Swimnato/Simulation-Main-Board/README.md

# Simulation Main Board
A universal board for creating simulation panels for the Christa McCaullife Space Center. Created and maintained by NF 2025.

For getting started with the library please visit the [Library Guide](Library%20Guide.md)
