Swimnato/Simulation-Main-Board/Release Packages/REV A0 - First Release/Example Good.png

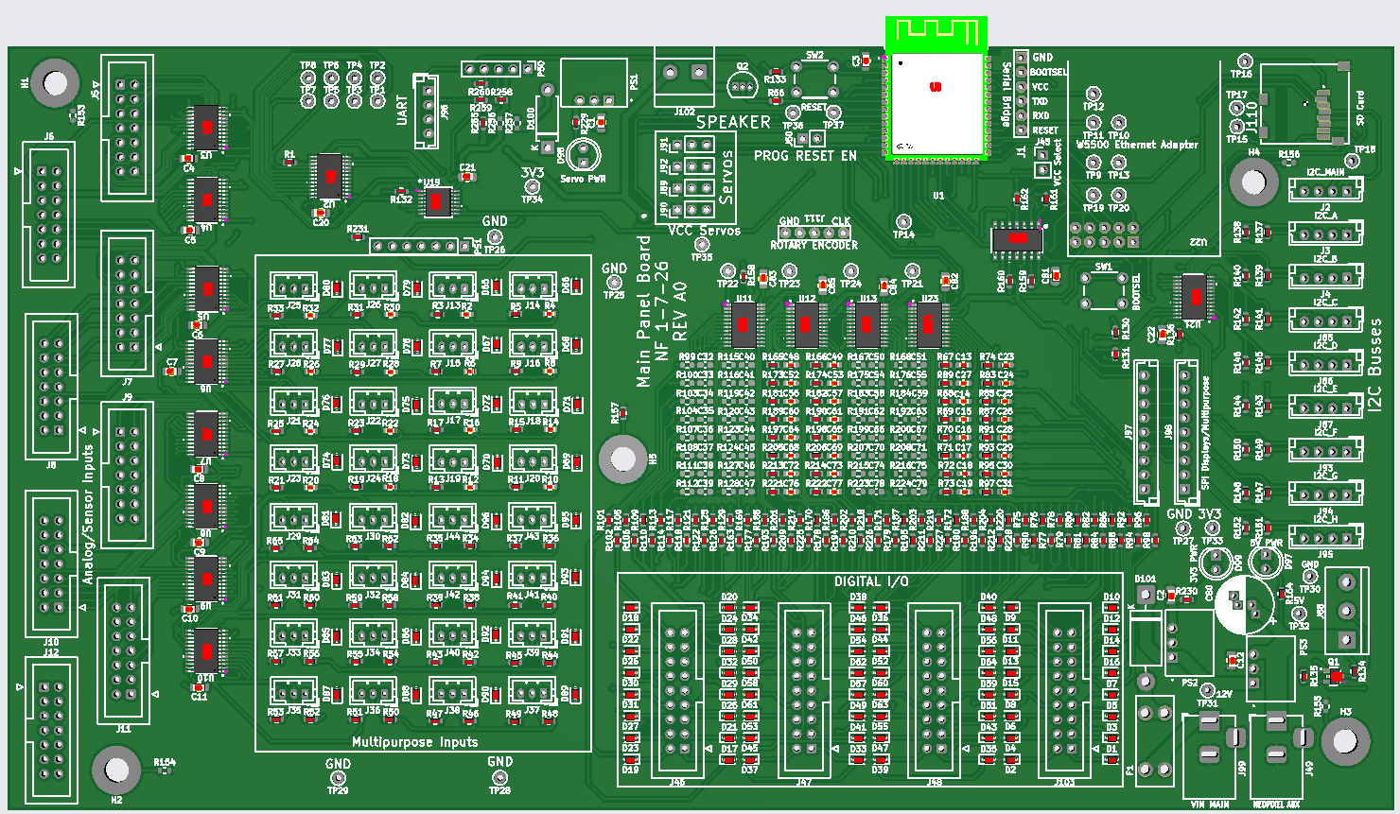
Release Packages/REV A0 - First Release/Example Good.png
