Swimnato/Simulation-Main-Board/Release Packages/REV A0 - First Release/Ali_Express Parts.xlsx

Designator | Description | link | QTY
Q2 | 2N2222 | https://www.aliexpress.us/item/3256808643065539.html | 1
C80 | 1000uF 50V | https://www.aliexpress.us/item/3256802338659126.html | 1
J46,J47,J48,J103 | 18 pin IDC Connector | https://www.aliexpress.us/item/3256808347400918.html | 4
J102 | 2 Pin Screw Block Terminal 5.08mm | https://www.aliexpress.us/item/2251832621219818.html | 1
D97,D98,D99 | 5mm LED (Color Doesn't matter) | https://www.aliexpress.us/item/3256805522196114.html | 3
D100 | Flyback Diode for servos | https://www.aliexpress.us/item/3256805353201767.html | 1
J99,(J49) | DC Barrel Jack | https://www.aliexpress.us/item/2255801020080942.html | 1
N/A | (mini) Blade Car Fuse 4A | https://www.aliexpress.us/item/3256809139622077.html | 1
U22 | W5500 (Blue) | https://www.aliexpress.us/item/3256808177680660.html | 1
