Swimnato/Simulation-Main-Board/Release Packages/REV A0 - First Release/Digikey Parts.xlsx

Designator(s) | Digikey Number | QTY
F1 | 36-3568-ND | 1
D97,D98,D99 | 5962-XL-502SYGD-ND | 3
PS1,PS3 | 945-R-78K5.0-2.0-ND | 2
PS2 | 945-R-78K3.3-2.0-ND | 1
J99 | 486-3381-ND | 1
D100 | 4878-1N4007CT-ND | 1
D101 | 497-6588-2-ND | 1
SW1,SW2 | 2223-TS02-66-60-BK-160-LCR-D-ND | 2
J97,J98 | 455-B9B-XH-A-ND | 2
J13-25, J29-44 | 455-2248-ND, or 455-B2B-XH-A-ND | 32
J5,J6,J7,J8,J9,J10,J11,J12 | S9170-ND | 8
J2,J3,J4,J85,J86,J87,J93,J94,J96 | 455-B4B-XH-A-ND | 10
