Swimnato/Simulation-Main-Board/Release Packages/REV A0 - First Release/BOM JLCPCB Assembly A0.xlsx

Comment | Designator | Footprint | JLCPCB Part #（optional）
ESP32-S3-WROOM-1-N4 | U1 |  | C2913197
BSS138 | Q1 | SOT95-3 | C52895
CD4067BPWR | U4,U3,U5,U2,U10,U6,U8,U9,U7 | 24-TSSOP | C2861251
SN74HCS164PWR | U19 | 14-TSSOP | C406867
74HC125D,653 | U30 | SO14 | C5598
TCA9548APWR | U21 | 24-TSSOP | C130026
TCA9535PWR | U11, U12, U13, U23 | 24-TSSOP | C130204
300R | R164, R229 | 603 | C23025
150R | R230,R169,R170,R201,R171,R193,R185,R82,R177,R81,R219,R129,R178,R114,R113,R211,R94,R172,R217,R188,R105,R226,R92,R86,R110,R187,R195,R88,R79,R109,R180,R84,R220,R121,R98,R186,R194,R126,R101,R227,R196,R117,R76,R202,R218,R96,R106,R203,R90,R78,R102,R228,R122,R212,R179,R125,R163,R209,R80,R204,R75,R118,R210,R225,R77 | 603 | C22808
MEM2061-01-188-00-A | J110 |  | C5151738
DESD5V0S1BA-7 | D87,D53,D37,D89,D81,D45,D60,D29,D88,D93,D75,D24,D47,D92,D73,D56,D70,D86,D84,D31,D6,D64,D83,D20,D19,D62,D67,D76,D8,D46,D5,D18,D66,D40,D82,D72,D25,D30,D36,D9,D65,D80,D90,D55,D50,D17,D26,D57,D38,D34,D15,D14,D59,D21,D10,D39,D58,D85,D13,D63,D35,D68,D16,D51,D61,D41,D42,D49,D1,D91,D69,D52,D77,D27,D78,D33,D74,D79,D7,D54,D22,D44,D94,D43,D96,D95,D28,D48,D12,D23,D32,D11,D2,D4,D3,D71 | SOD-323 | C2157964
10k | R1,R66,R130,R131,R132,R133,R134,R135,R136,R137,R138,R139,R140,R141,R142,R143,R144,R145,R146,R147,R148,R149,R150,R151,R152,R158,R258 | 603 | C98220
100k | R197,R173,R221,R181,R165,R205,R189,R213,R74,R160,R161,R69,R182,R89,R68,R198,R70,R87,R91,R206,R159,R214,R93,R95,R83,R166,R85,R190,R72,R162,R222,R174,R97,R67,R73,R71,R34,R35,R36,R37,R38,R39,R40,R41,R42,R43,R44,R45,R46,R47,R48,R49,R50,R51,R52,R53,R54,R55,R56,R57,R58,R59,R60,R61,R62,R63,R64,R65,R3,R5,R7,R9,R11,R13,R15,R17,R19,R21,R23,R25,R27,R29,R31,R33,R231,R259,R260 | 603 | C25803
0.1uF | C13,C14,C15,C16,C17,C18,C19,C23,C24,C25,C26,C27,C28,C29,C30,C31,C48,C49,C52,C53,C56,C57,C60,C61,C64,C65,C68,C69,C72,C73,C76,C77,R2,R4,R6,R8,R10,R12,R14,R16,R18,R20,R22,R24,R26,R28,R30,R32 | 603 | C14663
10uF | C9,C3,C5,C22,C4,C10,C11,C20,C8,C7,C21,C6,C81,C82,C83,C84,C85 | 805 | C15850
0R | R157,R255 | 603 | C21189
22uF | C2,C12,C1 | 805 | C45783
