Swimnato/Simulation-Main-Board/Release Packages/REV A0 - First Release/Main Board 3D Model A0.3mf

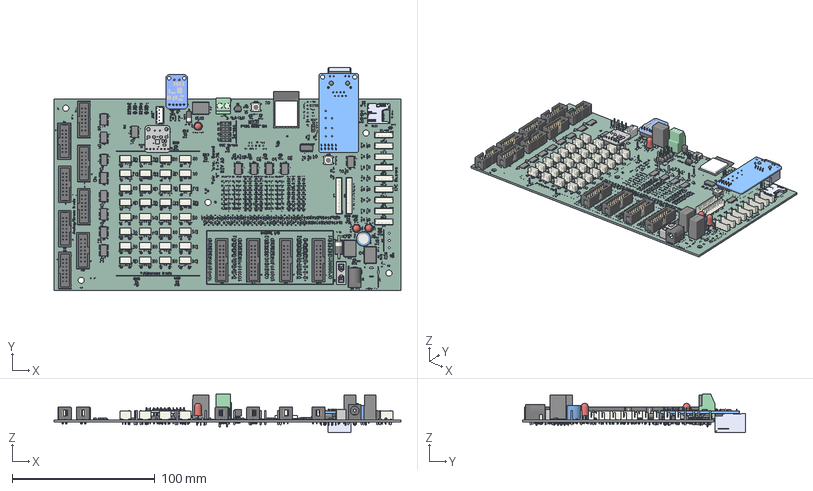
[picture p2: CAD file, 2026-01-08]
Release Packages/REV A0 - First Release/Main Board 3D Model A0.3mf
243.2 x 156.0 x 27.2 mm
