Swimnato/Simulation-Main-Board/3D Models/Components/2130 PAM8302.step

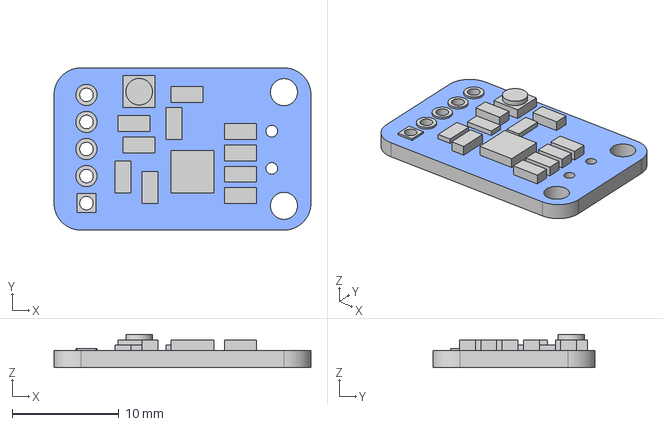
[picture p3: CAD file, 2026-01-07]
3D Models/Components/2130 PAM8302.step
24.1 x 15.2 x 3.10 mm
