Swimnato/Simulation-Main-Board/ESP32 S3/ESP32-S3-WROOM-1-N16.STEP

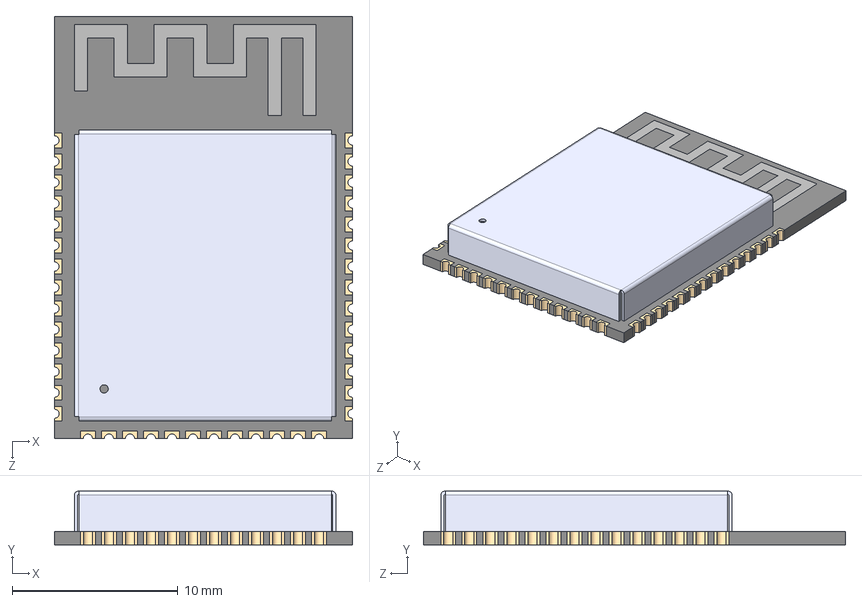
[picture p4: CAD file, 2025-09-20]
ESP32 S3/ESP32-S3-WROOM-1-N16.STEP
18.0 x 3.25 x 25.5 mm
