Swimnato/Simulation-Main-Board/3D Models/Components/3006 MAX98357.step

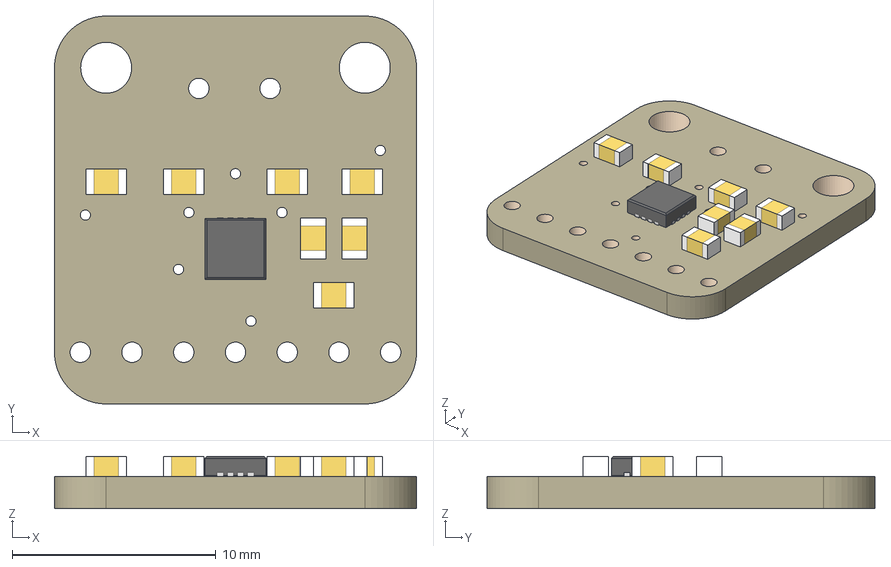
[picture p5: CAD file, 2026-01-07]
3D Models/Components/3006 MAX98357.step
17.8 x 19.1 x 2.57 mm
Board
MAX98357A
220pF x 7
