Swimnato/Simulation-Main-Board/3D Models/Components/JST XH 4 B4B-XH-A.STEP

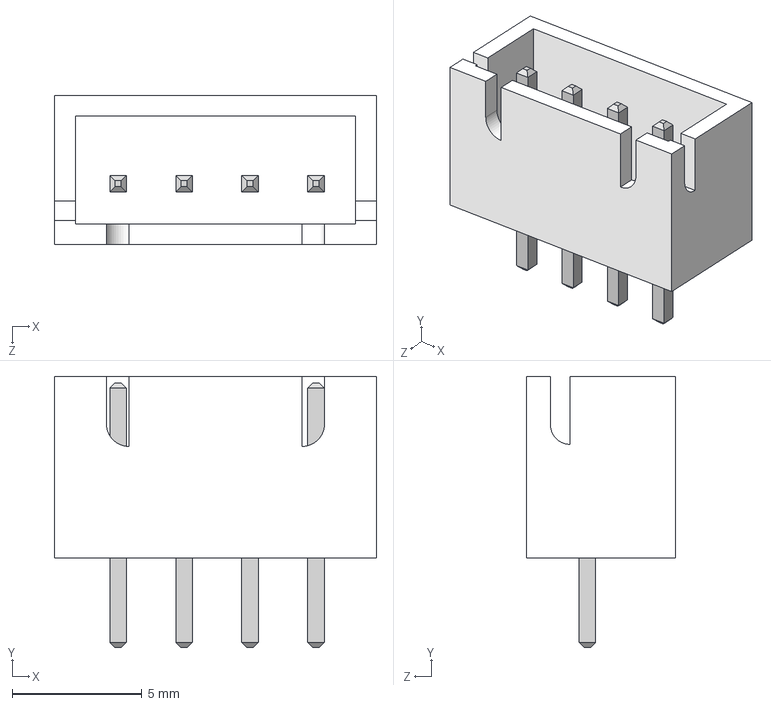
[picture p6: CAD file, 2026-01-07]
3D Models/Components/JST XH 4 B4B-XH-A.STEP
12.4 x 10.5 x 5.75 mm
