Swimnato/Simulation-Main-Board/Release Packages/REV A0 - First Release/JLCBPCB_Instructions.txt

Upload Main Board CAM Data A0.zip to JLCPCB (go to JLCPCB.com >> Instant Quote >> Drag zip into upload folder)

WAIT FOR THE PCB TO FINISH UPLOADING BEFORE EDITING PARAMETERS

Changes needed:
Surface Finish - LeadFree HASL
Enable PCB Assembly
Assemble Top Side
PCBA Type - Standard
Qty - 5
Confirm Parts Placement - Yes (ON POPUP "Do Not Confirm Automatically" to true) 
Board Cleaning - Yes

Hit NEXT

Verify the top side is showing (You should see text "Main Panel Board" in the center)

Hit NEXT

Upload BOM and CPL File
- BOM is "BOM JLCPCB Assembly A0.xlsx"
- CPL is "Main Board-pick-and-place_A0.csv"

YOU WILL GET "The BOM file doesn't match the CPL file, please check and re-upload the files."
AFTER HITTING PROCESS BECAUSE WE HAVE DNP COMPONENTS, THIS IS EXPECTED, PRESS CONTINUE

MAKE SURE all parts are selected, sometimes it de-selects the 0.1uF capacitors MAKE SURE THEY POPULATE

Hit NEXT

You will see a render of the PCB make sure that the parts are all populated
Exceptions include Through Hole components, R256, R257, R188, R158, R154, R153, as well as 4 out of the 8 rows of Capacitors and resistors under U11-U23

You can verify DNP parts by using the PNG attached or 3D model. The PNG is of the JLCPCB screen these files gave me, which is correct, this is a better reference than the 3D model. To open the 3D model go to https://3dviewer.net/ and upload "Main Board 3D Model A0.3mf" to see what it should look like (Through Hole parts can be ignored). 

If you see any other missing parts, make sure all the boxes are checked in the parts menu first, then if they are contact me directly.

Make sure the Purple dots for the ICs are aligned next to the white dots on the PCB (* for U19)

There is a PNG of what it should look like in this folder as well if you wish to compare.

Hit Next

Total Price should be around $207.59

Product Description: Reserch\Education\DIY\Entertainment >> Development Board

Save to Cart

Checkout as normal

If you have any questions during this process please reach out to me.
