Swimnato/Simulation-Main-Board/Release Packages/REV X0/Main Board Schematic REV X0.pdf

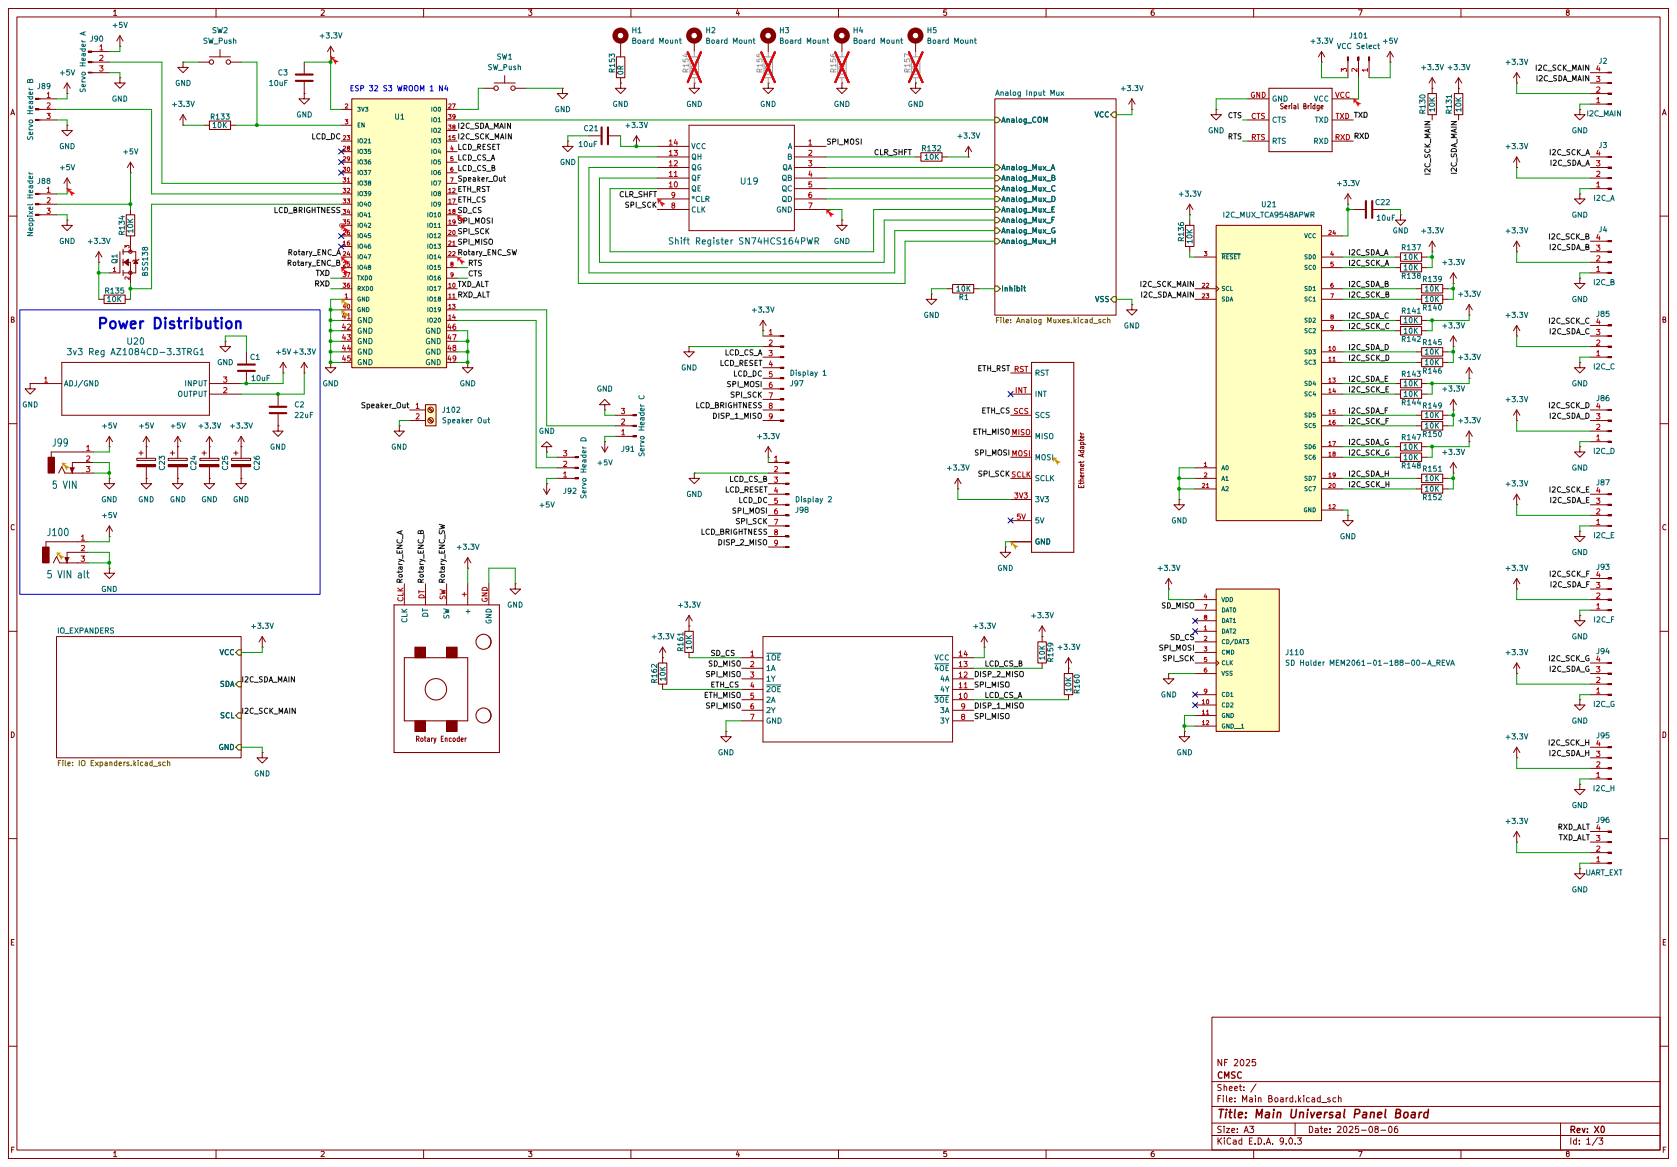
[picture p7: page 1]

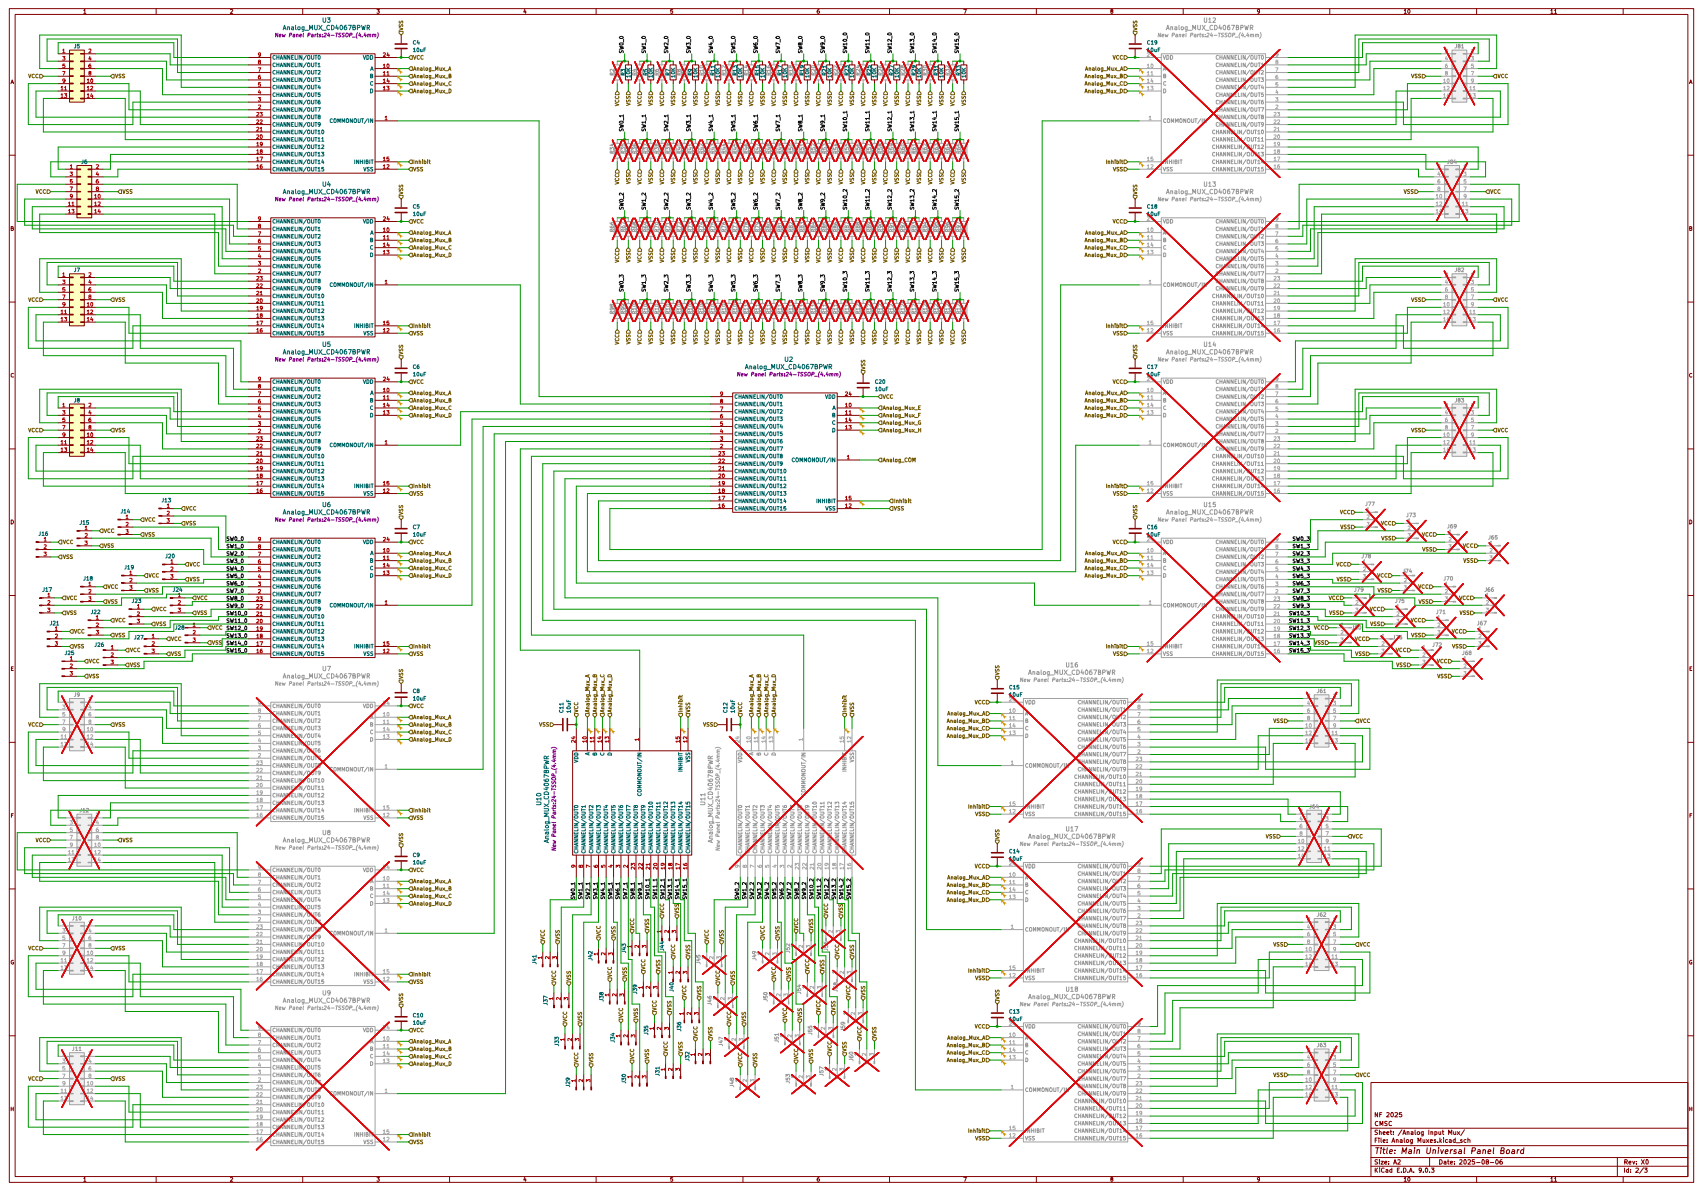
[picture p8: page 2]

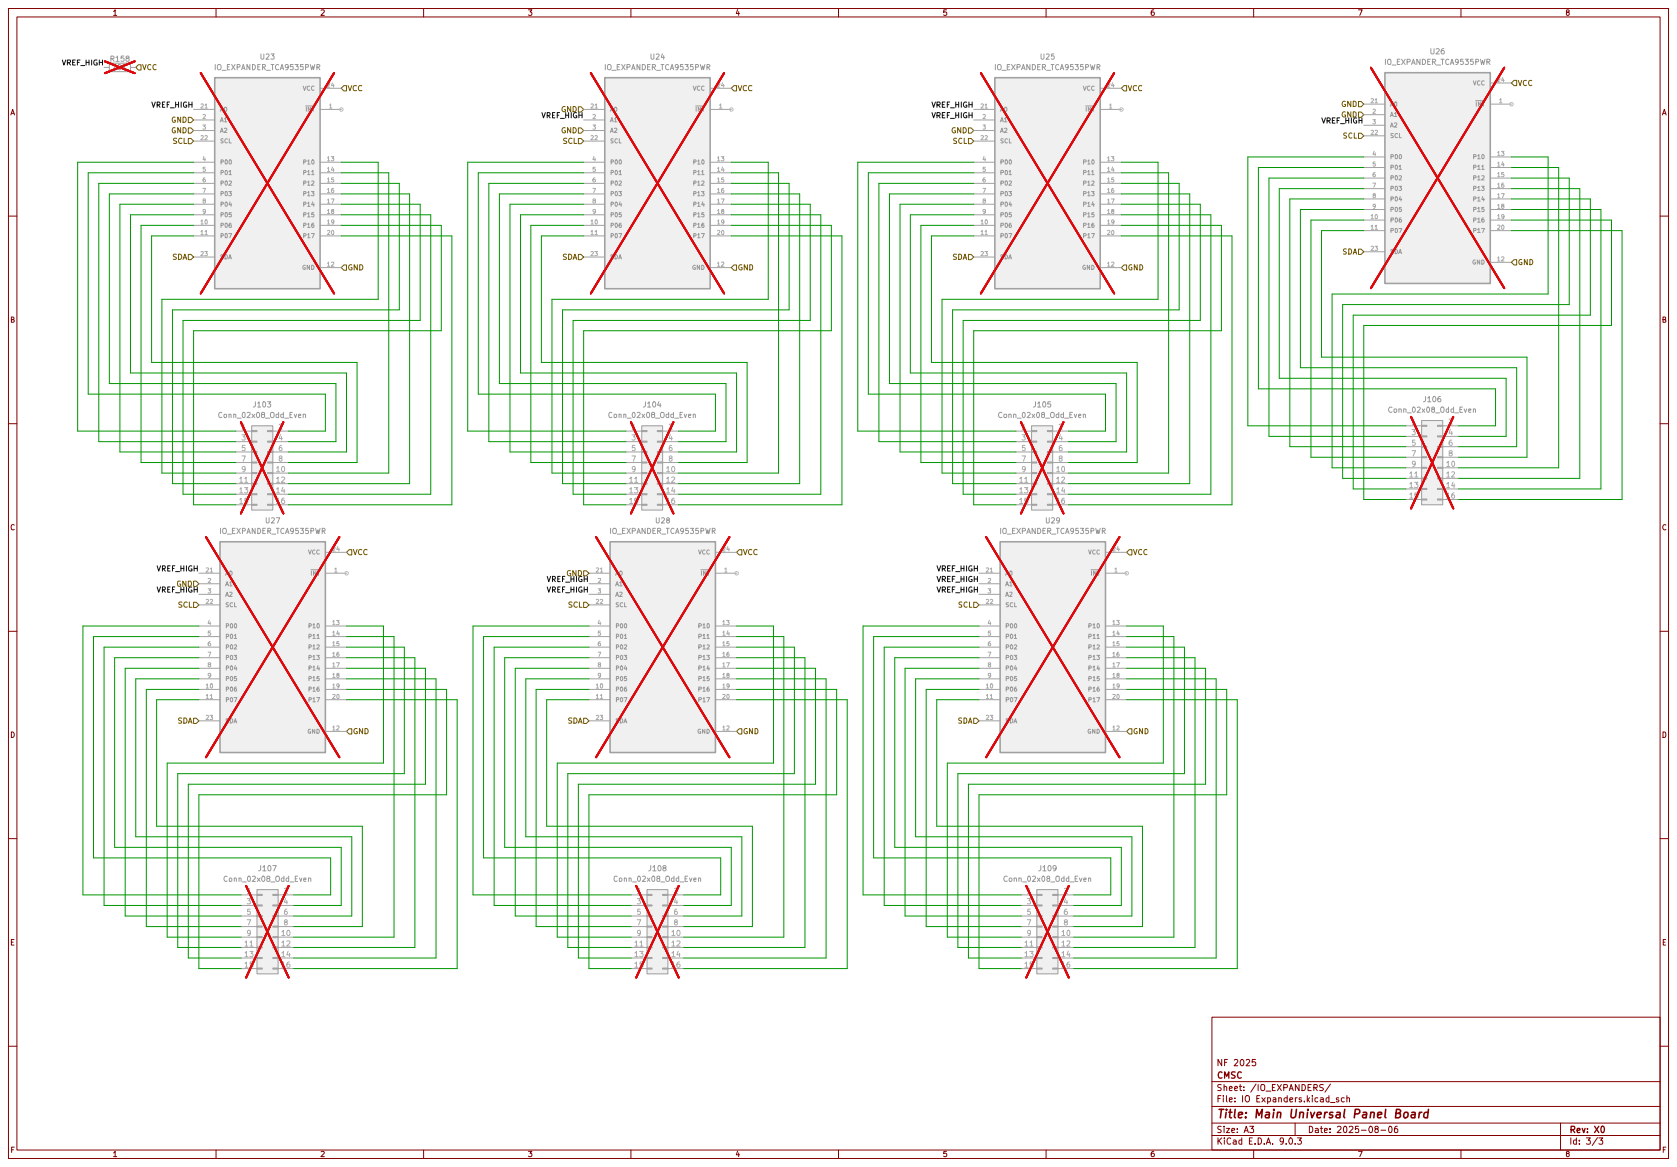
[picture p9: page 3]
