Swimnato/Simulation-Main-Board/Release Packages/REV X1/Main Board Schematic REV X1.pdf

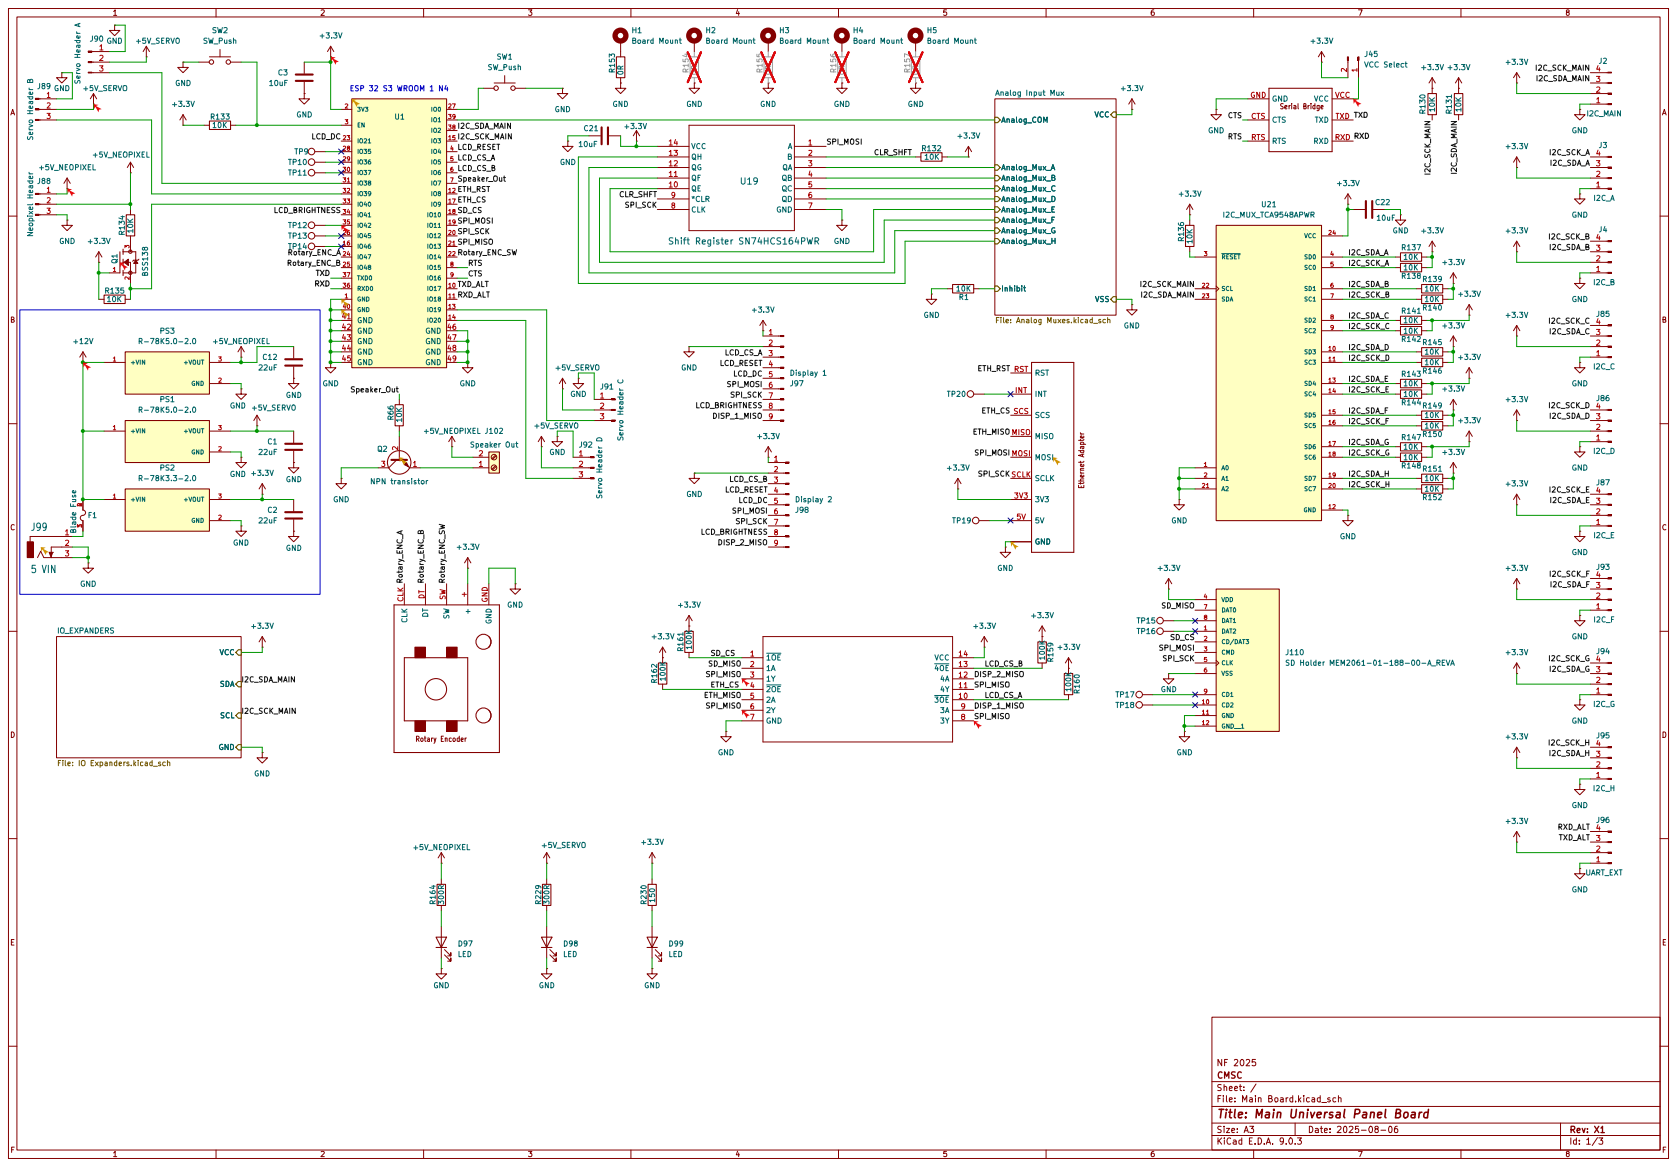
[picture p10: page 1]

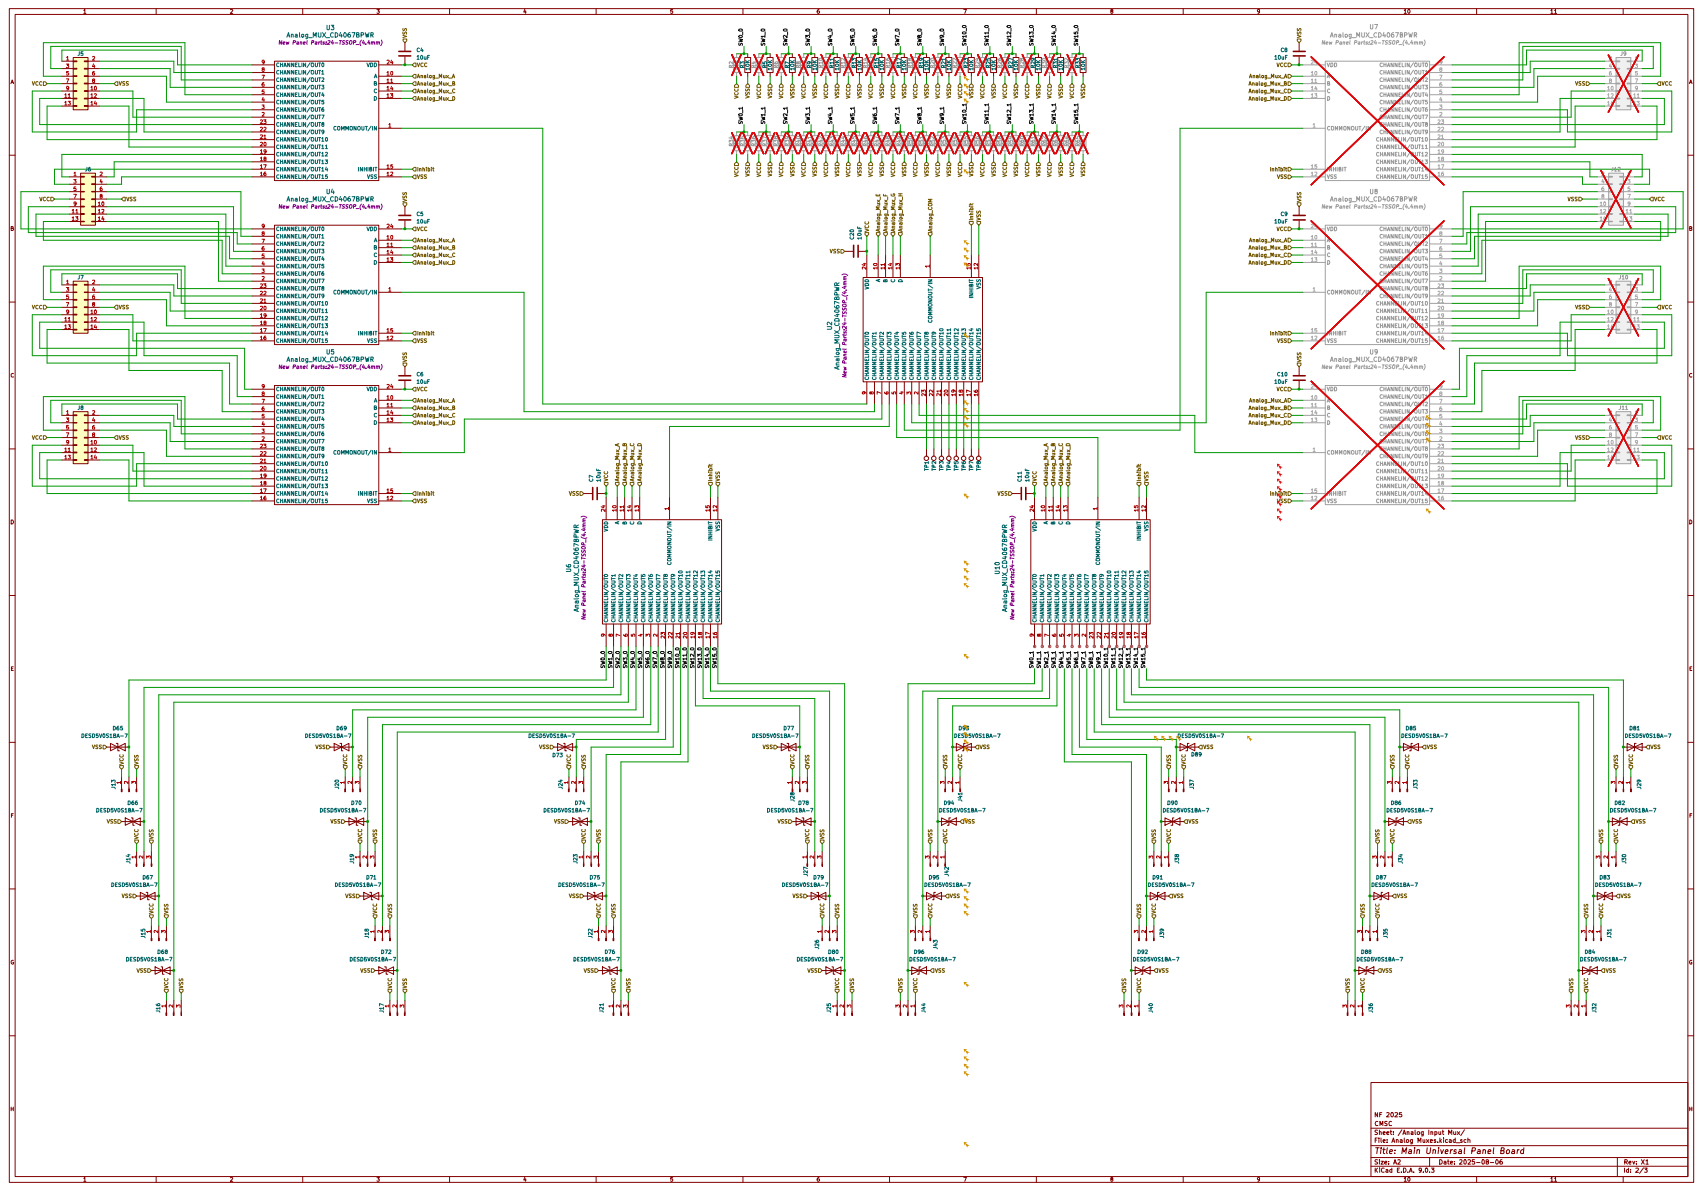
[picture p11: page 2]

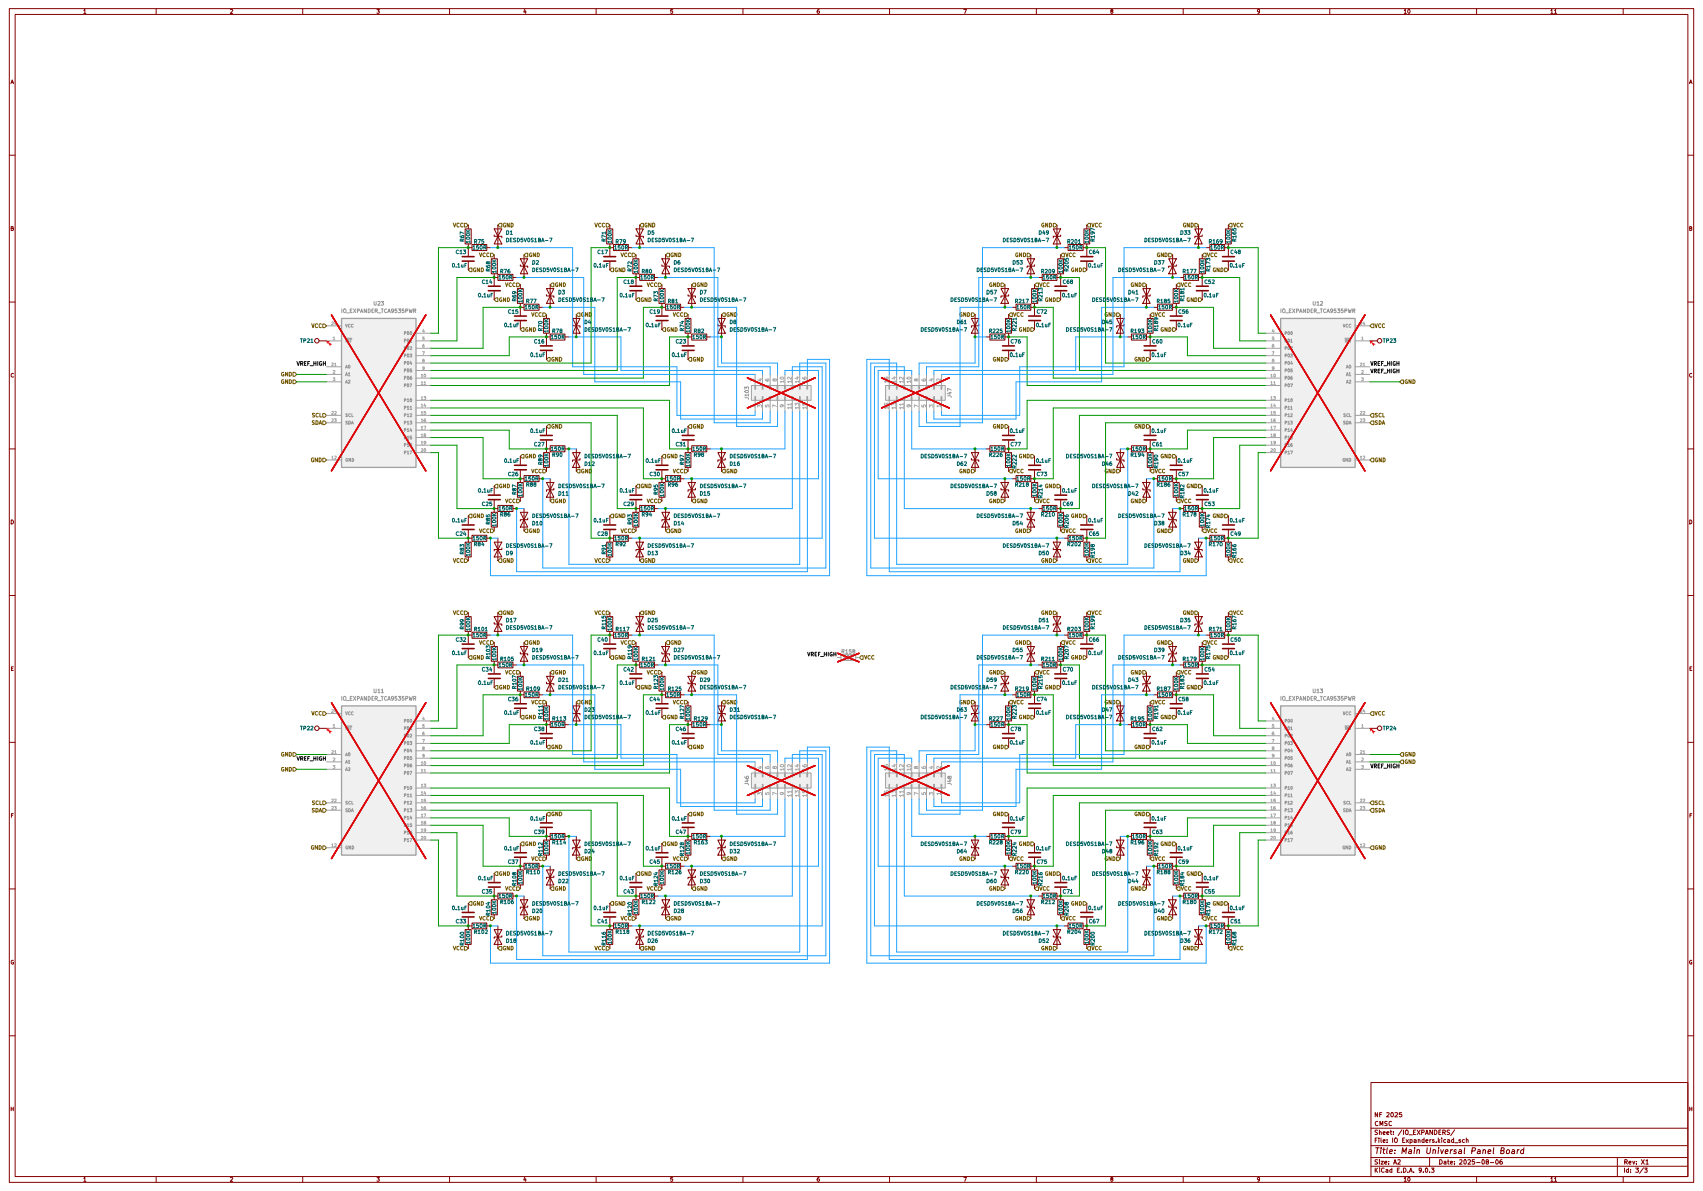
[picture p12: page 3]
