Swimnato/Simulation-Main-Board/Release Packages/REV A0 - First Release/Main Board SCH A0.pdf

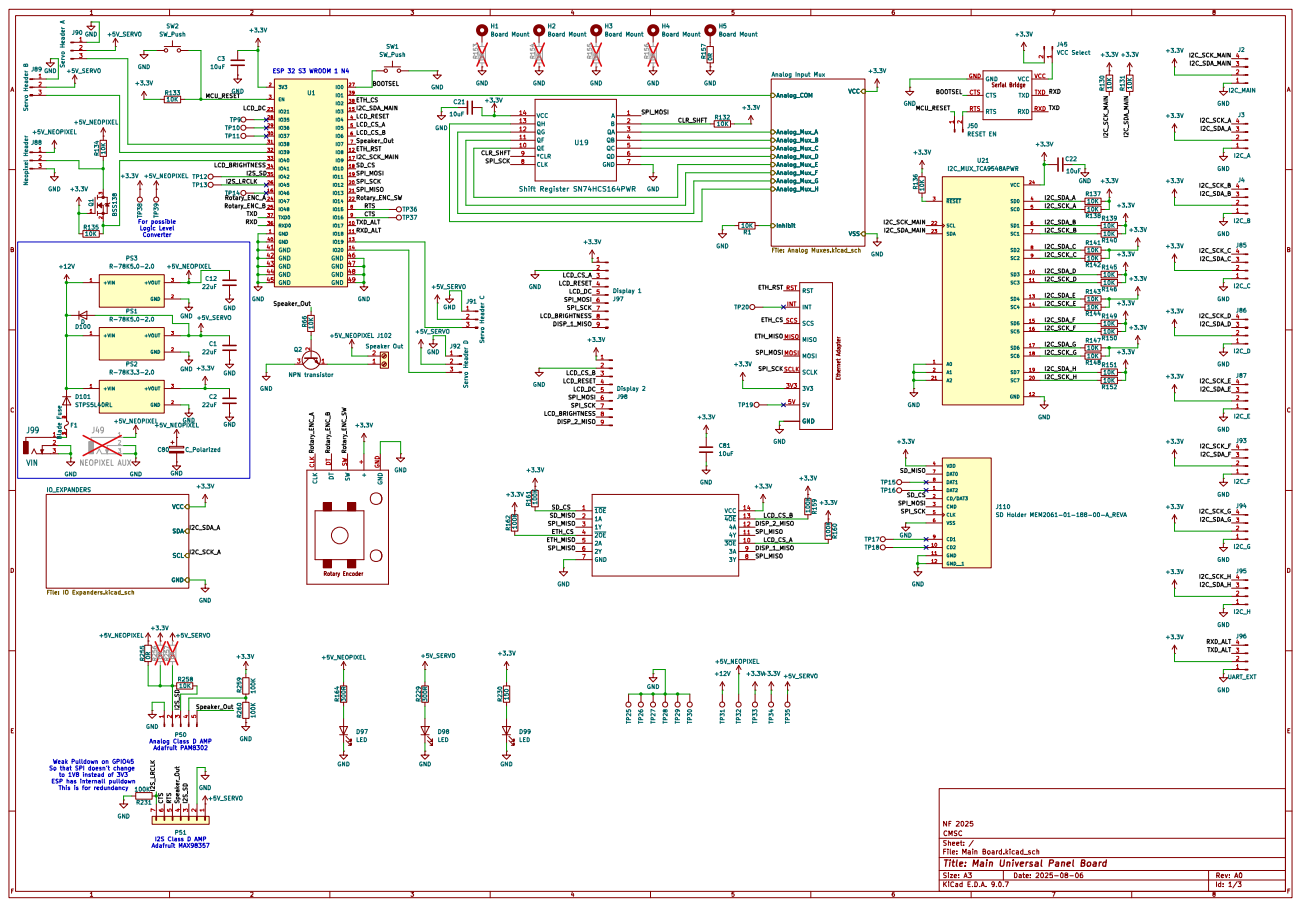
[picture p13: page 1]

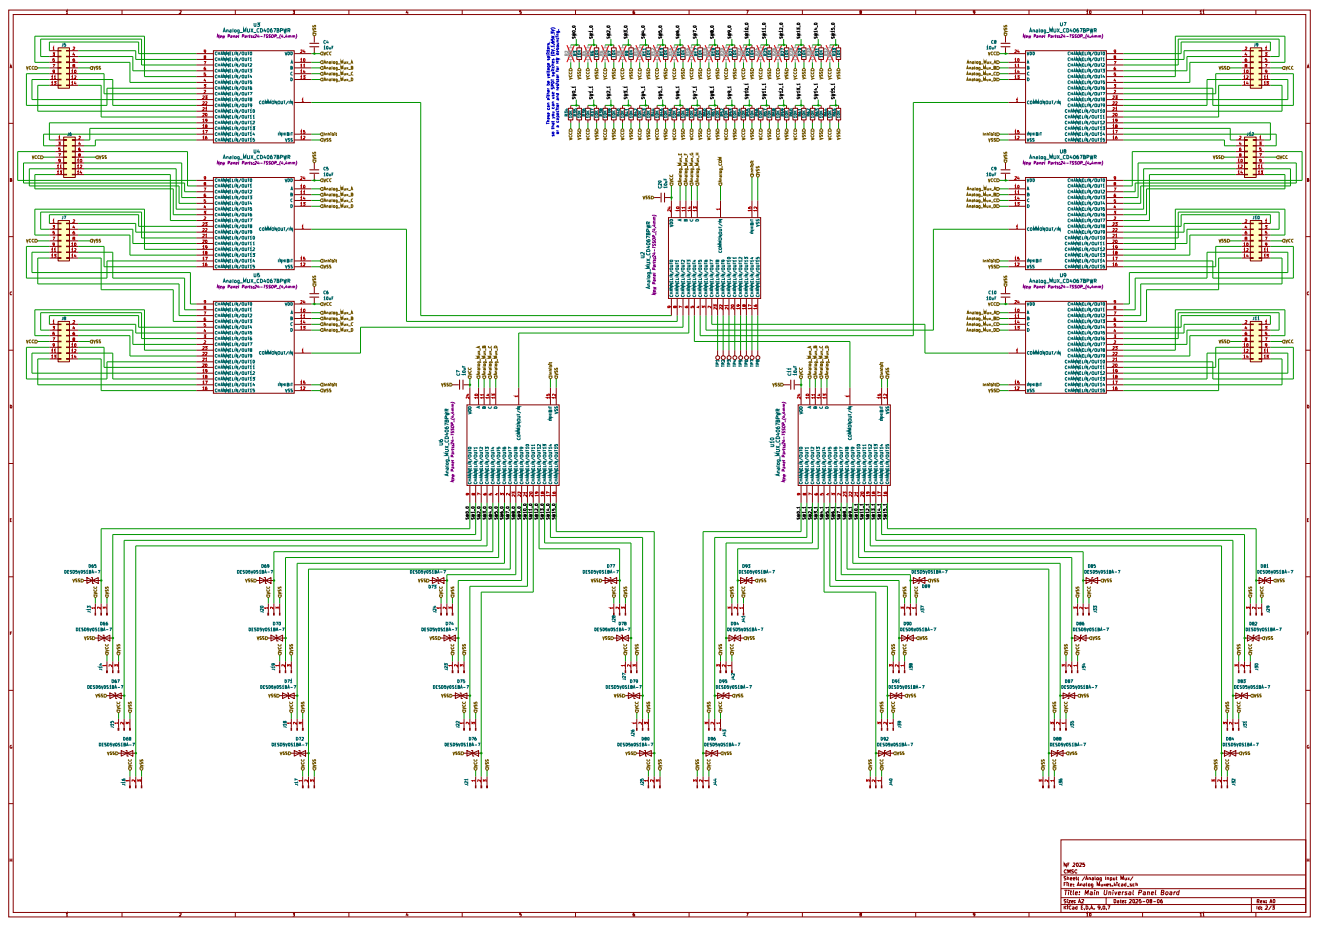
[picture p14: page 2]

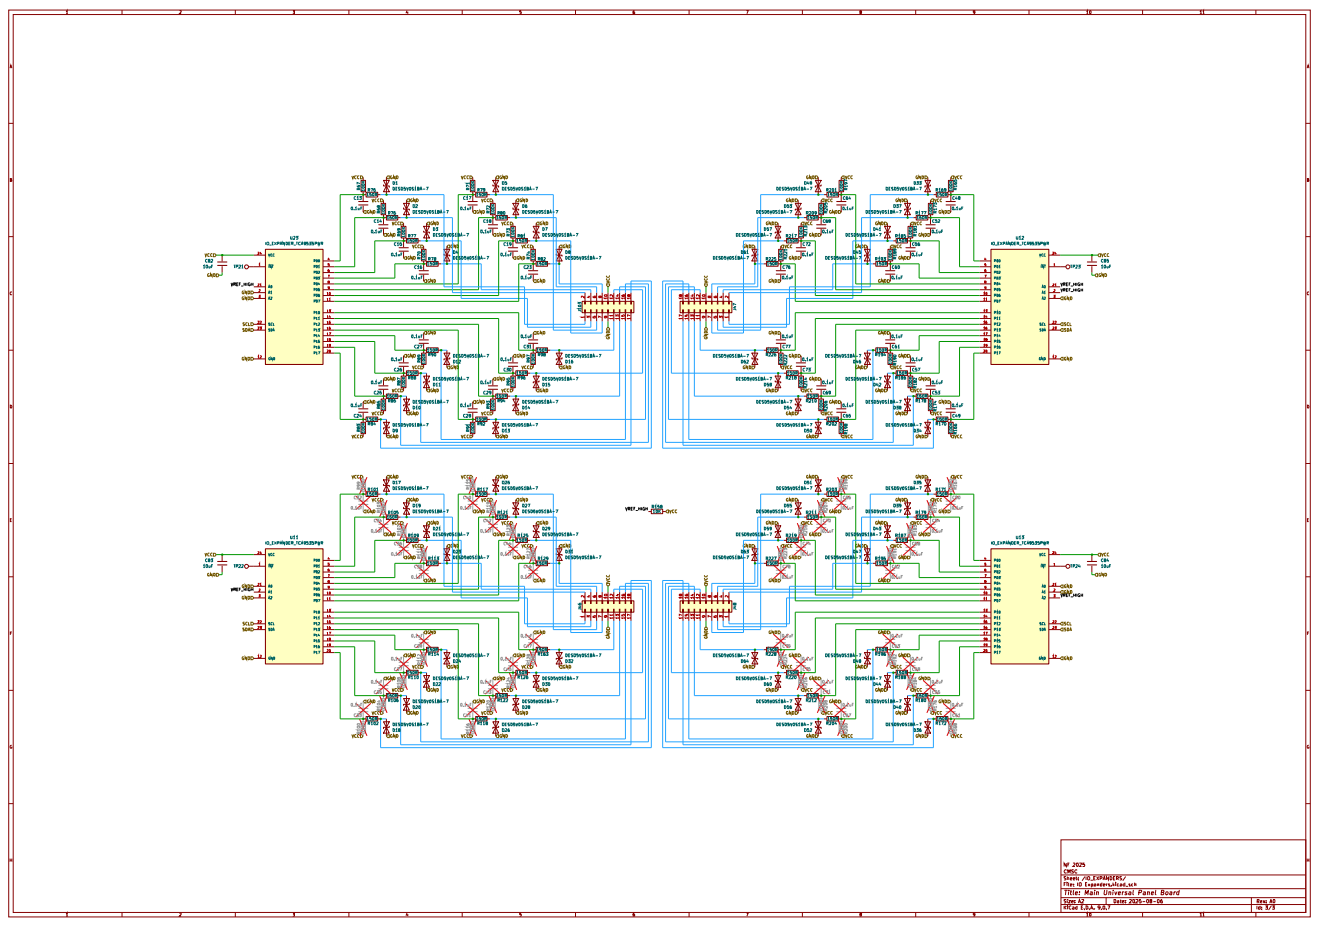
[picture p15: page 3]
