Swimnato/Simulation-Main-Board/Main Board.kicad_pcb

## KiCad design Main Board.kicad_pcb (2026-01-09)

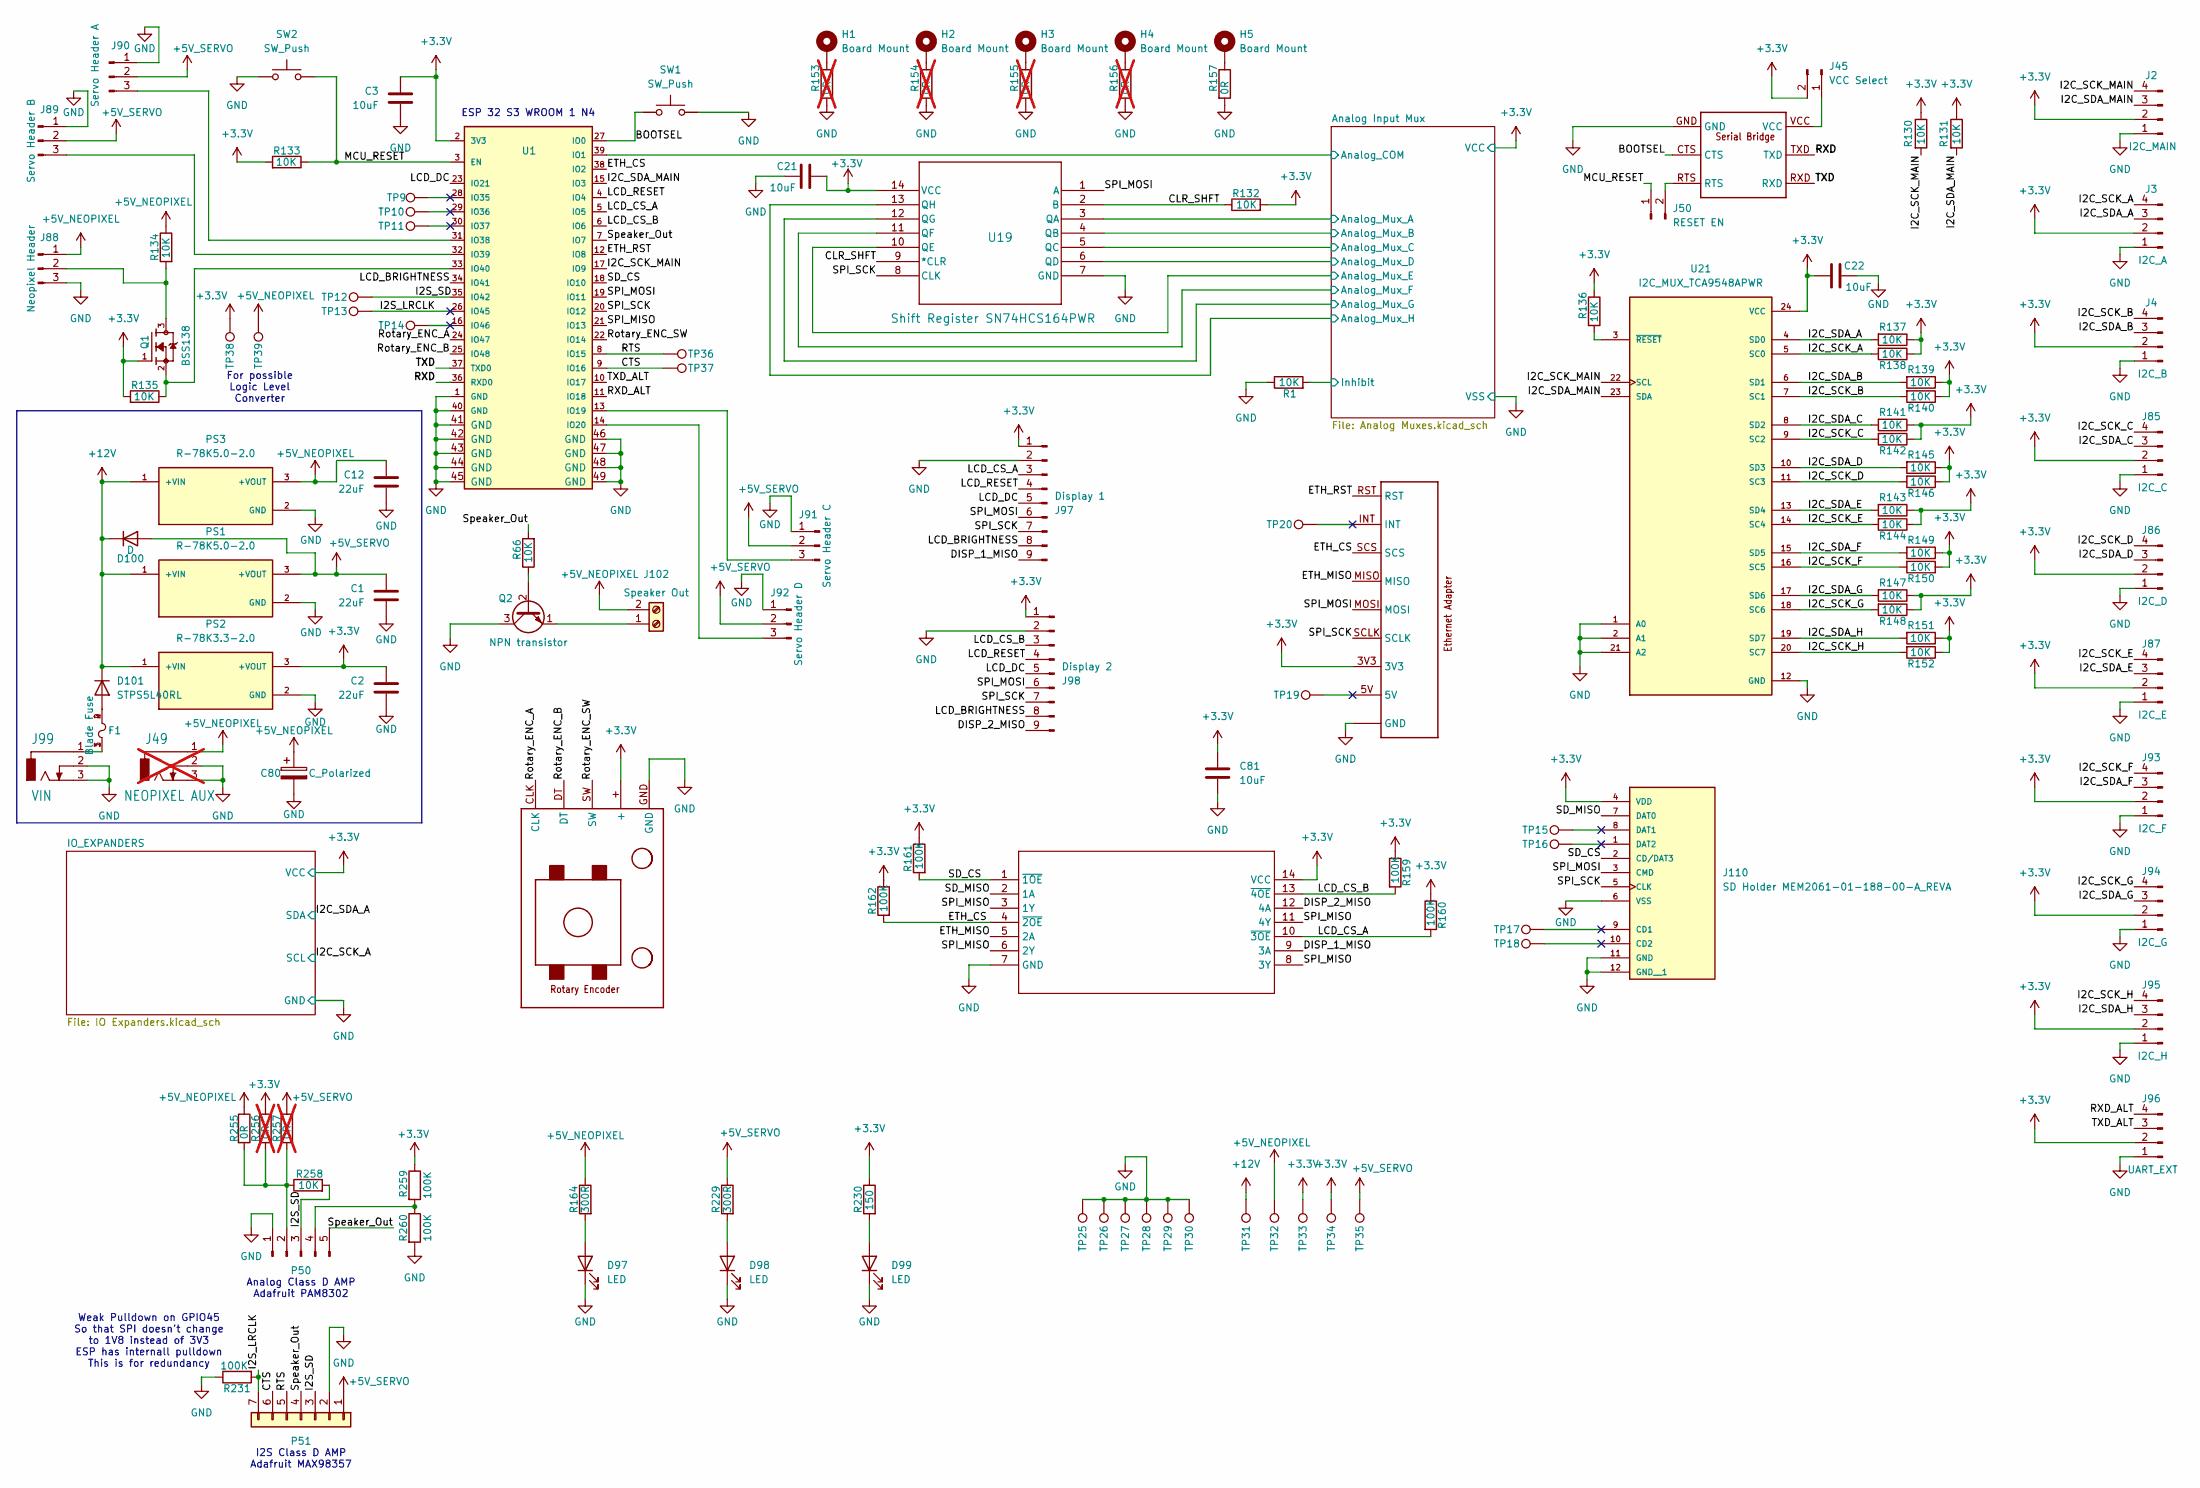
[picture p16: schematic Main Board.kicad_sch, Main Universal Panel Board]

Parts:
C1, C2, C12: 22uF; C_0805_2012Metric_Pad1.18x1.45mm_HandSolder
C3, C21, C22, C81: 10uF; C_0805_2012Metric_Pad1.18x1.45mm_HandSolder
C80: C_Polarized; CP_Radial_D10.0mm_P2.50mm_P5.00mm
D97, D98, D99: LED; LED_D5.0mm
D100: D; D_DO-15_P10.16mm_Horizontal
D101: STPS5L40RL; D_DO-201AD_P15.24mm_Horizontal
F1: Blade Fuse; FUSE_3568; PARTREV C
H1, H2, H3, H4, H5: Board Mount; MountingHole_4.3mm_M4_Pad
J1: UART_FTDI
J2: I2C_MAIN; JST_EH_B4B-EH-A_1x04_P2.50mm_Vertical
J3: I2C_A; JST_EH_B4B-EH-A_1x04_P2.50mm_Vertical
J4: I2C_B; JST_EH_B4B-EH-A_1x04_P2.50mm_Vertical
J45: VCC Select; PinHeader_1x02_P2.54mm_Vertical
J49: NEOPIXEL AUX; BarrelJack_Horizontal; not fitted
J50: RESET EN; PinHeader_1x02_P2.54mm_Vertical
J85: I2C_C; JST_EH_B4B-EH-A_1x04_P2.50mm_Vertical
J86: I2C_D; JST_EH_B4B-EH-A_1x04_P2.50mm_Vertical
J87: I2C_E; JST_EH_B4B-EH-A_1x04_P2.50mm_Vertical
J88: Neopixel Header; TerminalBlock_bornier-3_P5.08mm
J89: Servo Header B; PinHeader_1x03_P2.54mm_Vertical
J90: Servo Header A; PinHeader_1x03_P2.54mm_Vertical
J91: Servo Header C; PinHeader_1x03_P2.54mm_Vertical
J92: Servo Header D; PinHeader_1x03_P2.54mm_Vertical
J93: I2C_F; JST_EH_B4B-EH-A_1x04_P2.50mm_Vertical
J94: I2C_G; JST_EH_B4B-EH-A_1x04_P2.50mm_Vertical
J95: I2C_H; JST_EH_B4B-EH-A_1x04_P2.50mm_Vertical
J96: UART_EXT; JST_EH_B4B-EH-A_1x04_P2.50mm_Vertical
J97: Display 1; JST_EH_B9B-EH-A_1x09_P2.50mm_Vertical
J98: Display 2; JST_EH_B9B-EH-A_1x09_P2.50mm_Vertical
J99: VIN; BarrelJack_Horizontal
J102: Speaker Out; TerminalBlock_Phoenix_MKDS-3-2-5.08_1x02_P5.08mm_Horizontal
J110: SD Holder MEM2061-01-188-00-A_REVA; MicroSD Holder; Manufacturer Part Number MEM2061-01-188-00-A
J111: Rotary_Encoder_Header
P50: Conn_01x05_Pin; PinHeader_1x05_P2.54mm_Vertical
P51: Conn_01x07; PinHeader_1x07_P2.54mm_Vertical
PS1, PS3: R-78K5.0-2.0; CONV_R-78K5.0-2.0; PARTREV 0/2023
PS2: R-78K3.3-2.0; CONV_R-78K3.3-2.0; PARTREV 0/2023
Q1: BSS138; SOT95P240X111-3N; PARTREV 30 Jan 2018
Q2: NPN transistor; TO-92_Inline
R1, R66, R130, R131, R132, R133, R134, R135, R136, R137, R138, R139, R140, R141, R142, R143, R144, R145, R146, R147, R148, R149, R150, R151, R152, R258: 10K; R_0603_1608Metric
R153, R154, R155, R156, R256, R257: 0R; R_0603_1608Metric; not fitted
R157, R255: 0R; R_0603_1608Metric
R159, R160, R161, R162, R231, R259, R260: 100K; R_0603_1608Metric
R164, R229: 300R; R_0603_1608Metric
R230: 150; R_0603_1608Metric
SW1, SW2: SW_Push; SW_PUSH_6mm
TP9, TP10, TP11, TP12, TP13, TP14, TP15, TP16, TP17, TP18, TP19, TP20, TP25, TP26, TP27, TP28, TP29, TP30, TP31, TP32, TP33, TP34, TP35, TP36, TP37, TP38, TP39: TestPoint; Pin_D1.0mm_L10.0mm
U1: ESP32-S3-WROOM-1-N4; ESP32S3WROOM1N8R2; MANUFACTURER_PART_NUMBER ESP32-S3-WROOM-1-N4
U19: Shift Register SN74HCS164PWR; TSSOP14_PW_TEX; Manufacturer Part Number SN74HCS164PWR
U21: I2C_MUX_TCA9548APWR; 24-TSSOP_(4.4mm); PARTREV G
U22: Ethernet Adapter; W5500 Ethernet Module
U30: SO14_DIO; Manufacturer Part Number 74HC125D,653

Connections:
+3.3V: C2.1, C3.1, C21.1, C22.1, C81.2, J2.2, J3.2, J4.2, J45.2, J85.2, J86.2, J87.2, J93.2, J94.2, J95.2, J96.2, J97.1, J98.1, J110.4 (VDD), J111.+, PS2.3 (+VOUT), Q1.1, R130.1, R131.1, R132.2, R133.2, R135.2, R136.1, R137.1, R138.1, R139.1, R140.1, R141.1, R142.1, R143.1, R144.1, R145.1, R146.1, R147.1, R148.1, R149.1, R150.1, R151.1, R152.1, R159.1, R160.1, R161.1, R162.1, R230.1, R256.1, R259.1, TP33.1, TP34.1, TP38.1, U1.2 (3V3), U19.14 (VCC), U21.24 (VCC), U22.3V3, U30.14 (VCC); also elsewhere on the board
+5V_NEOPIXEL: C12.1, C80.1, J49.1, J88.1, J102.2, PS3.3 (+VOUT), R134.1, R164.1, R255.1, TP32.1, TP39.1
+5V_SERVO: C1.1, D100.2 (A), J89.2, J90.2, J91.2, J92.2, P51.1, PS1.3 (+VOUT), R229.1, R257.1, TP35.1
+12V: D100.1 (K), D101.1 (K), PS1.1 (+VIN), PS2.1 (+VIN), PS3.1 (+VIN), TP31.1
/Analog Input Mux/Analog_COM: U1.39 (IO1); also elsewhere on the board
/Analog Input Mux/Analog_Mux_A: U19.3 (QA); also elsewhere on the board
/Analog Input Mux/Analog_Mux_B: U19.4 (QB); also elsewhere on the board
/Analog Input Mux/Analog_Mux_C: U19.5 (QC); also elsewhere on the board
/Analog Input Mux/Analog_Mux_D: U19.6 (QD); also elsewhere on the board
/Analog Input Mux/Analog_Mux_E: U19.10 (QE); also elsewhere on the board
/Analog Input Mux/Analog_Mux_F: U19.11 (QF); also elsewhere on the board
/Analog Input Mux/Analog_Mux_G: U19.12 (QG); also elsewhere on the board
/Analog Input Mux/Analog_Mux_H: U19.13 (QH); also elsewhere on the board
/Analog Input Mux/Inhibit: R1.2; also elsewhere on the board
/BOOTSEL: J1.CTS, SW1.1, U1.27 (IO0)
/CLR_SHFT: R132.1, U19.2 (B), U19.9 (*CLR)
/CTS: P51.6, TP37.1, U1.9 (IO16)
/DISP_1_MISO: J97.9, U30.9 (3A)
/DISP_2_MISO: J98.9, U30.12 (4A)
/ETH_CS: R162.2, U1.38 (IO2), U22.SCS, U30.4 (~2OE)
/ETH_MISO: U22.MISO, U30.5 (2A)
/ETH_RST: U1.12 (IO8), U22.RST
/I2C_SCK_A: J3.4, R138.2, U21.5 (SC0); also elsewhere on the board
/I2C_SCK_B: J4.4, R140.2, U21.7 (SC1)
/I2C_SCK_C: J85.4, R142.2, U21.9 (SC2)
/I2C_SCK_D: J86.4, R146.2, U21.11 (SC3)
/I2C_SCK_E: J87.4, R144.2, U21.14 (SC4)
/I2C_SCK_F: J93.4, R150.2, U21.16 (SC5)
/I2C_SCK_G: J94.4, R148.2, U21.18 (SC6)
/I2C_SCK_H: J95.4, R152.2, U21.20 (SC7)
/I2C_SCK_MAIN: J2.4, R130.2, U1.17 (IO9), U21.22 (SCL)
/I2C_SDA_A: J3.3, R137.2, U21.4 (SD0); also elsewhere on the board
/I2C_SDA_B: J4.3, R139.2, U21.6 (SD1)
/I2C_SDA_C: J85.3, R141.2, U21.8 (SD2)
/I2C_SDA_D: J86.3, R145.2, U21.10 (SD3)
/I2C_SDA_E: J87.3, R143.2, U21.13 (SD4)
/I2C_SDA_F: J93.3, R149.2, U21.15 (SD5)
/I2C_SDA_G: J94.3, R147.2, U21.17 (SD6)
/I2C_SDA_H: J95.3, R151.2, U21.19 (SD7)
/I2C_SDA_MAIN: J2.3, R131.2, U1.15 (IO3), U21.23 (SDA)
/I2S_LRCLK: P51.7, R231.2, TP13.1, U1.26 (IO45)
/I2S_SD: P50.3, P51.3, R258.2, TP12.1, U1.35 (IO42)
/LCD_BRIGHTNESS: J97.8, J98.8, U1.34 (IO41)
/LCD_CS_A: J97.3, R160.2, U1.5 (IO5), U30.10 (~3OE)
/LCD_CS_B: J98.3, R159.2, U1.6 (IO6), U30.13 (~4OE)
/LCD_DC: J97.5, J98.5, U1.23 (IO21)
/LCD_RESET: J97.4, J98.4, U1.4 (IO4)
/MCU_RESET: J50.1, R133.1, SW2.1, U1.3 (EN)
/RTS: P51.5, TP36.1, U1.8 (IO15)
/RXD: J1.TXD, U1.36 (RXD0)
/RXD_ALT: J96.4, U1.11 (IO18)
/Rotary_ENC_A: J111.CLK, U1.24 (IO47)
/Rotary_ENC_B: J111.DT, U1.25 (IO48)
/Rotary_ENC_SW: J111.SW, U1.22 (IO14)
/SD_CS: J110.2 (CD/DAT3), R161.2, U1.18 (IO10), U30.1 (~1OE)
/SD_MISO: J110.7 (DAT0), U30.2 (1A)
/SPI_MISO: U1.21 (IO13), U30.3 (1Y), U30.6 (2Y), U30.8 (3Y), U30.11 (4Y)
/SPI_MOSI: J97.6, J98.6, J110.3 (CMD), U1.19 (IO11), U19.1 (A), U22.MOSI
/SPI_SCK: J97.7, J98.7, J110.5 (CLK), U1.20 (IO12), U19.8 (CLK), U22.SCLK
/Speaker_Out: P50.5, P51.4, R66.2, U1.7 (IO7)
/TXD: J1.RXD, U1.37 (TXD0)
/TXD_ALT: J96.3, U1.10 (IO17)
GND: C1.2, C2.2, C3.2, C12.2, C21.2, C22.2, C80.2, C81.1, D97.1 (K), D98.1 (K), D99.1 (K), J1.GND, J2.1, J3.1, J4.1, J49.2, J49.3, J85.1, J86.1, J87.1, J88.3, J89.1, J90.1, J91.1, J92.1, J93.1, J94.1, J95.1, J96.1, J97.2, J98.2, J99.2, J99.3, J110.6 (VSS), J110.11 (GND), J110.12 (GND__1), J111.GND, P50.1, P51.2, PS1.2 (GND), PS2.2 (GND), PS3.2 (GND), Q2.3 (C), R1.1, R153.2, R154.2, R155.2, R156.2, R157.2, R231.1, R260.2, SW1.2, SW2.2, TP25.1, TP26.1, TP27.1, TP28.1, TP29.1, TP30.1, U1.1 (GND), U1.40 (GND), U1.41 (GND), U1.42 (GND), U1.43 (GND), U1.44 (GND), U1.45 (GND), U1.46 (GND), U1.47 (GND), U1.48 (GND), U1.49 (GND), U19.7 (GND), U21.1 (A0), U21.2 (A1), U21.12 (GND), U21.21 (A2), U22.GND@1 (GND), U22.GND@2 (GND), U30.7 (GND); also elsewhere on the board
unnamed: D97.2 (A), R164.2
unnamed: D98.2 (A), R229.2
unnamed: D99.2 (A), R230.2
unnamed: D101.2 (A), F1.2, F1.4
unnamed: F1.1, F1.3, J99.1
unnamed: H1.1, R153.1
unnamed: H2.1, R154.1
unnamed: H3.1, R155.1
unnamed: H4.1, R156.1
unnamed: H5.1, R157.1
unnamed: J1.VCC, J45.1
unnamed: J1.RTS, J50.2
unnamed: J88.2, Q1.3, R134.2
unnamed: J89.3, U1.32 (IO39)
unnamed: J90.3, U1.31 (IO38)
unnamed: J91.3, U1.13 (IO19)
unnamed: J92.3, U1.14 (IO20)
unnamed: J102.1, Q2.1 (E)
unnamed: P50.2, R255.2, R256.2, R257.2, R258.1
unnamed: P50.4, R259.2, R260.1
unnamed: Q2.2 (B), R66.1
unnamed: Q1.2, R135.1, U1.33 (IO40)
unnamed: R136.2, U21.3 (~RESET)

Notes on the sheet:
ESP 32 S3 WROOM 1 N4
I2S Class D AMP Adafruit MAX98357
For possible Logic Level Converter
Weak Pulldown on GPIO45 So that SPI doesn't change to 1V8 instead of 3V3 ESP has internall pulldown This is for redundancy
Analog Class D AMP Adafruit PAM8302

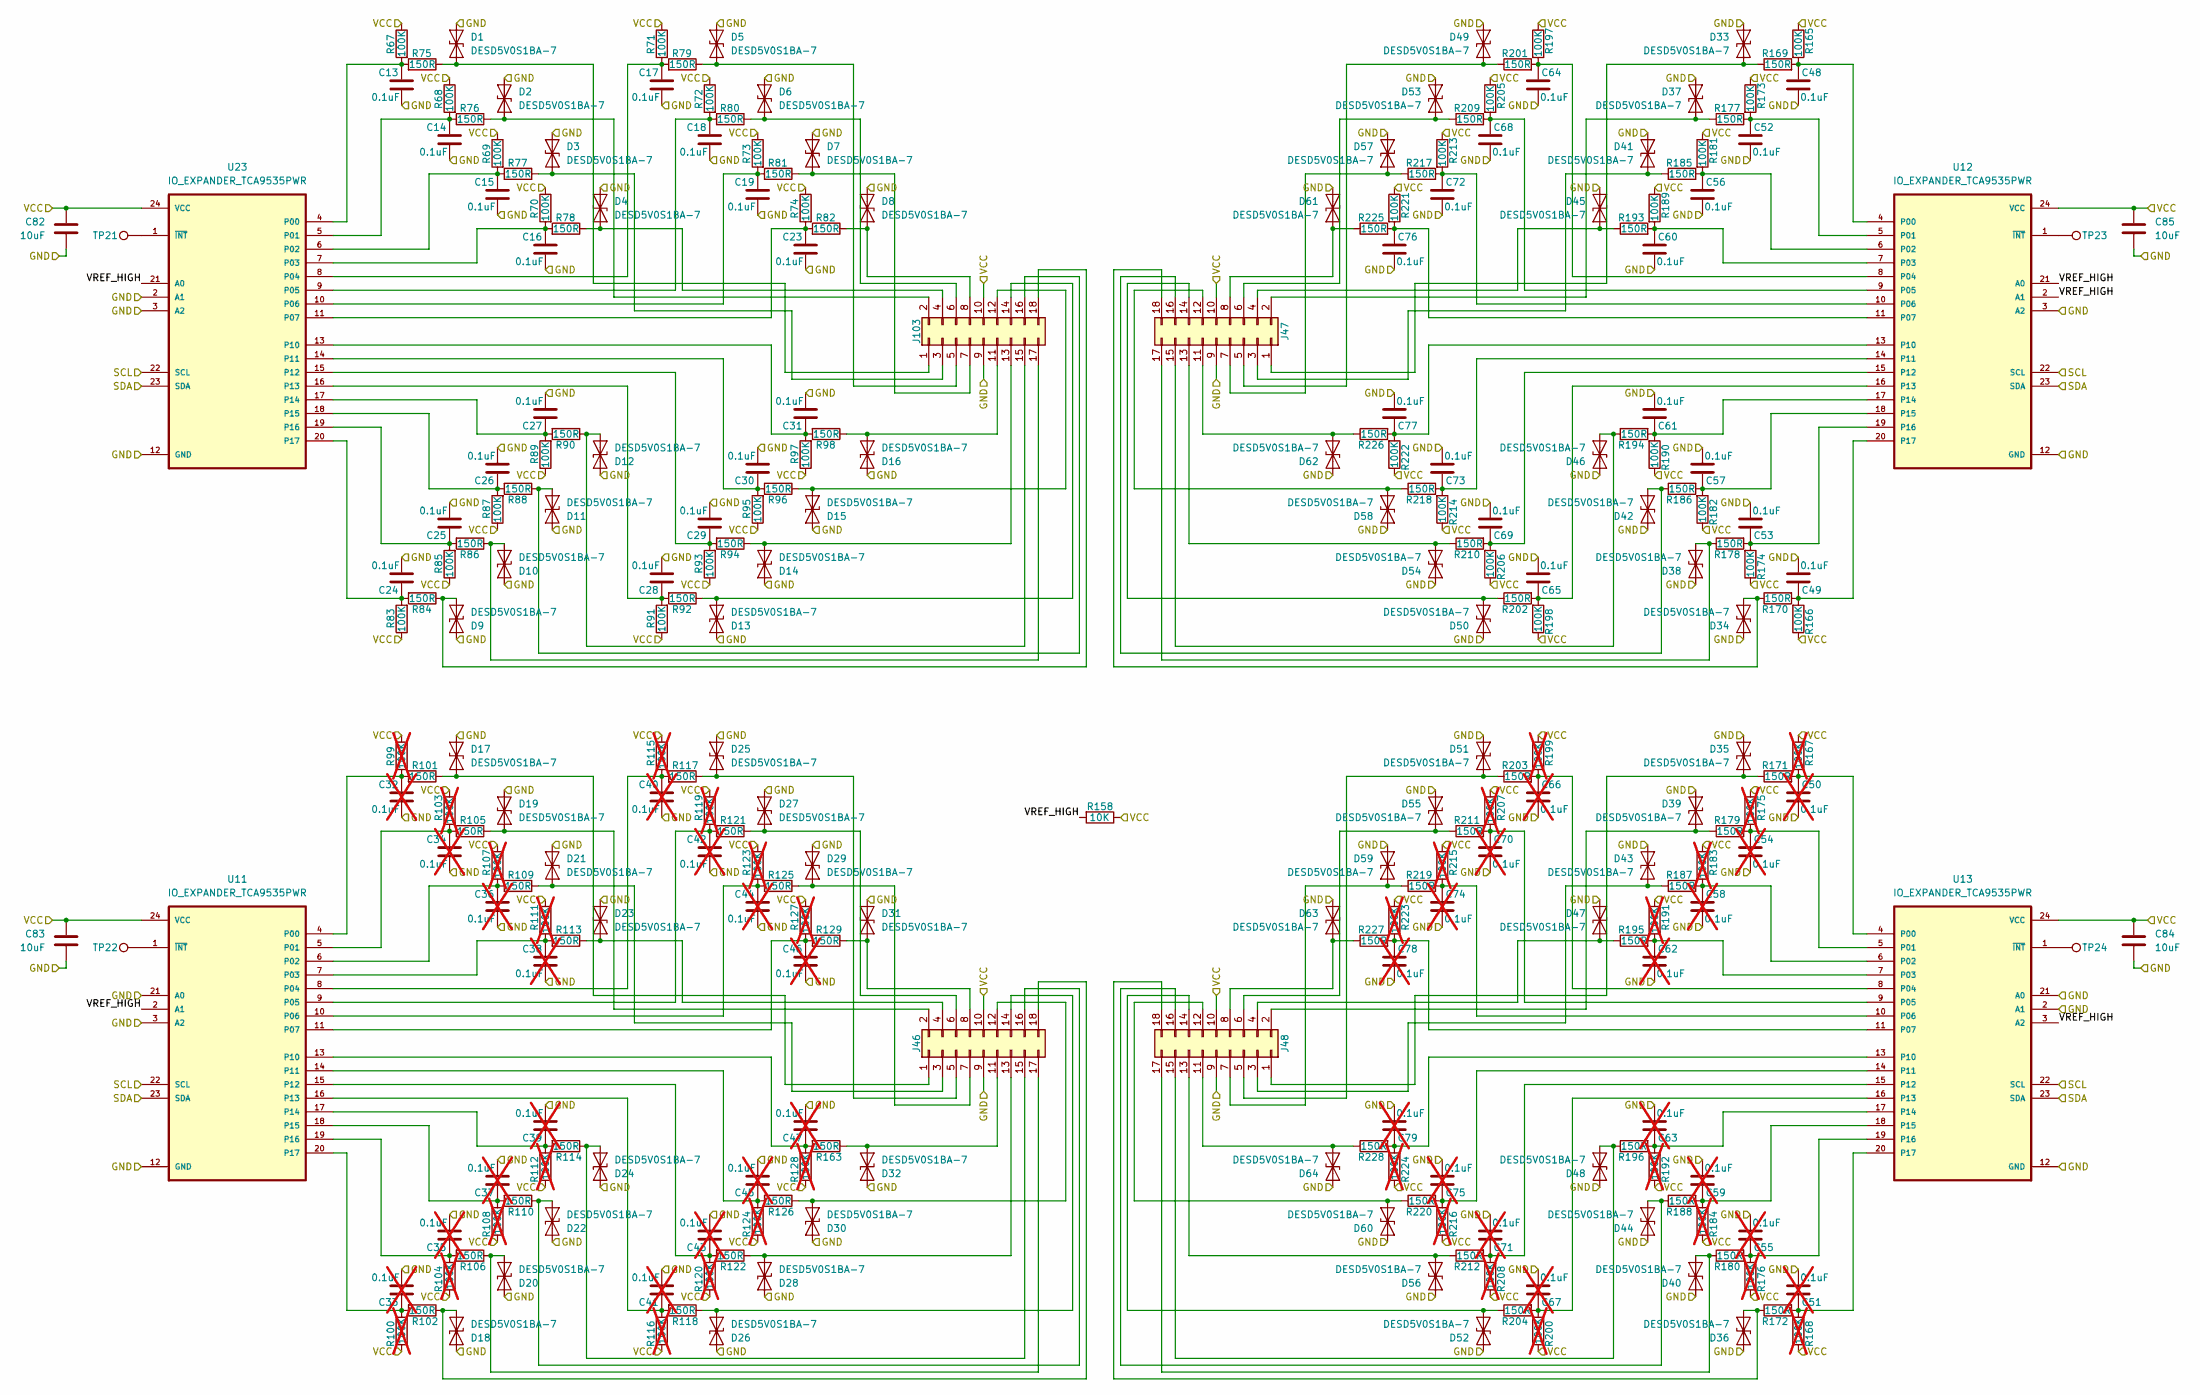
[picture p17: schematic IO Expanders.kicad_sch, Main Universal Panel Board]

Parts:
C13, C14, C15, C16, C17, C18, C19, C23, C24, C25, C26, C27, C28, C29, C30, C31, C48, C49, C52, C53, C56, C57, C60, C61, C64, C65, C68, C69, C72, C73, C76, C77: 0.1uF; C_0603_1608Metric_Pad1.08x0.95mm_HandSolder
C32, C33, C34, C35, C36, C37, C38, C39, C40, C41, C42, C43, C44, C45, C46, C47, C50, C51, C54, C55, C58, C59, C62, C63, C66, C67, C70, C71, C74, C75, C78, C79: 0.1uF; C_0603_1608Metric_Pad1.08x0.95mm_HandSolder; not fitted
C82, C83, C84, C85: 10uF; C_0805_2012Metric_Pad1.18x1.45mm_HandSolder
D1, D2, D3, D4, D5, D6, D7, D8, D9, D10, D11, D12, D13, D14, D15, D16, D17, D18, D19, D20, D21, D22, D23, D24, D25, D26, D27, D28, D29, D30, D31, D32, D33, D34, D35, D36, D37, D38, D39, D40, D41, D42, D43, D44, D45, D46, D47, D48, D49, D50, D51, D52, D53, D54, D55, D56, D57, D58, D59, D60, D61, D62, D63, D64: DESD5V0S1BA-7; D_SOD-323
J46, J47, J48, J103: Conn_02x08_Odd_Even; IDC-Header_2x09_P2.54mm_Vertical
R67, R68, R69, R70, R71, R72, R73, R74, R83, R85, R87, R89, R91, R93, R95, R97, R165, R166, R173, R174, R181, R182, R189, R190, R197, R198, R205, R206, R213, R214, R221, R222: 100K; R_0603_1608Metric
R75, R76, R77, R78, R79, R80, R81, R82, R84, R86, R88, R90, R92, R94, R96, R98, R101, R102, R105, R106, R109, R110, R113, R114, R117, R118, R121, R122, R125, R126, R129, R163, R169, R170, R171, R172, R177, R178, R179, R180, R185, R186, R187, R188, R193, R194, R195, R196, R201, R202, R203, R204, R209, R210, R211, R212, R217, R218, R219, R220, R225, R226, R227, R228: 150R; R_0603_1608Metric
R99, R100, R103, R104, R107, R108, R111, R112, R115, R116, R119, R120, R123, R124, R127, R128, R167, R168, R175, R176, R183, R184, R191, R192, R199, R200, R207, R208, R215, R216, R223, R224: 100K; R_0603_1608Metric; not fitted
R158: 10K; R_0603_1608Metric
TP21, TP22, TP23, TP24: TestPoint; Pin_D1.0mm_L10.0mm
U11, U12, U13, U23: IO_EXPANDER_TCA9535PWR; 24-TSSOP_(4.4mm); Manufacturer Part Number TCA9535PWR

Connections:
+3.3V: C82.2, C83.2, C84.2, C85.2, J46.10, J47.10, J48.10, J103.10, R67.1, R68.1, R69.1, R70.1, R71.1, R72.1, R73.1, R74.1, R83.1, R85.1, R87.1, R89.1, R91.1, R93.1, R95.1, R97.1, R99.1, R100.1, R103.1, R104.1, R107.1, R108.1, R111.1, R112.1, R115.1, R116.1, R119.1, R120.1, R123.1, R124.1, R127.1, R128.1, R158.1, R165.1, R166.1, R167.1, R168.1, R173.1, R174.1, R175.1, R176.1, R181.1, R182.1, R183.1, R184.1, R189.1, R190.1, R191.1, R192.1, R197.1, R198.1, R199.1, R200.1, R205.1, R206.1, R207.1, R208.1, R213.1, R214.1, R215.1, R216.1, R221.1, R222.1, R223.1, R224.1, U11.24 (VCC), U12.24 (VCC), U13.24 (VCC), U23.24 (VCC); also elsewhere on the board
/I2C_SCK_A: U11.22 (SCL), U12.22 (SCL), U13.22 (SCL), U23.22 (SCL); also elsewhere on the board
/I2C_SDA_A: U11.23 (SDA), U12.23 (SDA), U13.23 (SDA), U23.23 (SDA); also elsewhere on the board
/IO_EXPANDERS/VREF_HIGH: R158.2, U11.2 (A1), U12.2 (A1), U12.21 (A0), U13.3 (A2), U23.21 (A0)
GND: C13.2, C14.2, C15.2, C16.2, C17.2, C18.2, C19.2, C23.2, C24.2, C25.2, C26.2, C27.2, C28.2, C29.2, C30.2, C31.2, C32.2, C33.2, C34.2, C35.2, C36.2, C37.2, C38.2, C39.2, C40.2, C41.2, C42.2, C43.2, C44.2, C45.2, C46.2, C47.2, C48.2, C49.2, C50.2, C51.2, C52.2, C53.2, C54.2, C55.2, C56.2, C57.2, C58.2, C59.2, C60.2, C61.2, C62.2, C63.2, C64.2, C65.2, C66.2, C67.2, C68.2, C69.2, C70.2, C71.2, C72.2, C73.2, C74.2, C75.2, C76.2, C77.2, C78.2, C79.2, C82.1, C83.1, C84.1, C85.1, D1.2 (A2), D2.2 (A2), D3.2 (A2), D4.2 (A2), D5.2 (A2), D6.2 (A2), D7.2 (A2), D8.2 (A2), D9.2 (A2), D10.2 (A2), D11.2 (A2), D12.2 (A2), D13.2 (A2), D14.2 (A2), D15.2 (A2), D16.2 (A2), D17.2 (A2), D18.2 (A2), D19.2 (A2), D20.2 (A2), D21.2 (A2), D22.2 (A2), D23.2 (A2), D24.2 (A2), D25.2 (A2), D26.2 (A2), D27.2 (A2), D28.2 (A2), D29.2 (A2), D30.2 (A2), D31.2 (A2), D32.2 (A2), D33.2 (A2), D34.2 (A2), D35.2 (A2), D36.2 (A2), D37.2 (A2), D38.2 (A2), D39.2 (A2), D40.2 (A2), D41.2 (A2), D42.2 (A2), D43.2 (A2), D44.2 (A2), D45.2 (A2), D46.2 (A2), D47.2 (A2), D48.2 (A2), D49.2 (A2), D50.2 (A2), D51.2 (A2), D52.2 (A2), D53.2 (A2), D54.2 (A2), D55.2 (A2), D56.2 (A2), D57.2 (A2), D58.2 (A2), D59.2 (A2), D60.2 (A2), D61.2 (A2), D62.2 (A2), D63.2 (A2), D64.2 (A2), J46.9, J47.9, J48.9, J103.9, U11.3 (A2), U11.12 (GND), U11.21 (A0), U12.3 (A2), U12.12 (GND), U13.2 (A1), U13.12 (GND), U13.21 (A0), U23.2 (A1), U23.3 (A2), U23.12 (GND); also elsewhere on the board
unnamed: D1.1 (A1), J103.1, R75.1
unnamed: D2.1 (A1), J103.2, R76.1
unnamed: D3.1 (A1), J103.3, R77.1
unnamed: D4.1 (A1), J103.4, R78.1
unnamed: D5.1 (A1), J103.5, R79.1
unnamed: D6.1 (A1), J103.6, R80.1
unnamed: D7.1 (A1), J103.7, R81.1
unnamed: D8.1 (A1), J103.8, R82.1
unnamed: D9.1 (A1), J103.18, R84.1
unnamed: D10.1 (A1), J103.17, R86.1
unnamed: D11.1 (A1), J103.16, R88.1
unnamed: D12.1 (A1), J103.15, R90.1
unnamed: D13.1 (A1), J103.14, R92.1
unnamed: D14.1 (A1), J103.13, R94.1
unnamed: D15.1 (A1), J103.12, R96.1
unnamed: D16.1 (A1), J103.11, R98.1
unnamed: D17.1 (A1), J46.1, R101.1
unnamed: D18.1 (A1), J46.18, R102.1
unnamed: D19.1 (A1), J46.2, R105.1
unnamed: D20.1 (A1), J46.17, R106.1
unnamed: D21.1 (A1), J46.3, R109.1
unnamed: D22.1 (A1), J46.16, R110.1
unnamed: D23.1 (A1), J46.4, R113.1
unnamed: D24.1 (A1), J46.15, R114.1
unnamed: D25.1 (A1), J46.5, R117.1
unnamed: D26.1 (A1), J46.14, R118.1
unnamed: D27.1 (A1), J46.6, R121.1
unnamed: D28.1 (A1), J46.13, R122.1
unnamed: D29.1 (A1), J46.7, R125.1
unnamed: D30.1 (A1), J46.12, R126.1
unnamed: D31.1 (A1), J46.8, R129.1
unnamed: D32.1 (A1), J46.11, R163.1
unnamed: D33.1 (A1), J47.1, R169.1
unnamed: D34.1 (A1), J47.18, R170.1
unnamed: D35.1 (A1), J48.1, R171.1
unnamed: D36.1 (A1), J48.18, R172.1
unnamed: D37.1 (A1), J47.2, R177.1
unnamed: D38.1 (A1), J47.17, R178.1
unnamed: D39.1 (A1), J48.2, R179.1
unnamed: D40.1 (A1), J48.17, R180.1
unnamed: D41.1 (A1), J47.3, R185.1
unnamed: D42.1 (A1), J47.16, R186.1
unnamed: D43.1 (A1), J48.3, R187.1
unnamed: D44.1 (A1), J48.16, R188.1
unnamed: D45.1 (A1), J47.4, R193.1
unnamed: D46.1 (A1), J47.15, R194.1
unnamed: D47.1 (A1), J48.4, R195.1
unnamed: D48.1 (A1), J48.15, R196.1
unnamed: D49.1 (A1), J47.5, R201.1
unnamed: D50.1 (A1), J47.14, R202.1
unnamed: D51.1 (A1), J48.5, R203.1
unnamed: D52.1 (A1), J48.14, R204.1
unnamed: D53.1 (A1), J47.6, R209.1
unnamed: D54.1 (A1), J47.13, R210.1
unnamed: D55.1 (A1), J48.6, R211.1
unnamed: D56.1 (A1), J48.13, R212.1
unnamed: D57.1 (A1), J47.7, R217.1
unnamed: D58.1 (A1), J47.12, R218.1
unnamed: D59.1 (A1), J48.7, R219.1
unnamed: D60.1 (A1), J48.12, R220.1
unnamed: D61.1 (A1), J47.8, R225.1
unnamed: D62.1 (A1), J47.11, R226.1
unnamed: D63.1 (A1), J48.8, R227.1
unnamed: D64.1 (A1), J48.11, R228.1
unnamed: C32.1, R99.2, R101.2, U11.4 (P00)
unnamed: C34.1, R103.2, R105.2, U11.5 (P01)
unnamed: C36.1, R107.2, R109.2, U11.6 (P02)
unnamed: C38.1, R111.2, R113.2, U11.7 (P03)
unnamed: C40.1, R115.2, R117.2, U11.8 (P04)
unnamed: C42.1, R119.2, R121.2, U11.9 (P05)
unnamed: C44.1, R123.2, R125.2, U11.10 (P06)
unnamed: C46.1, R127.2, R129.2, U11.11 (P07)
unnamed: C47.1, R128.2, R163.2, U11.13 (P10)
unnamed: C45.1, R124.2, R126.2, U11.14 (P11)
unnamed: C43.1, R120.2, R122.2, U11.15 (P12)
unnamed: C41.1, R116.2, R118.2, U11.16 (P13)
unnamed: C39.1, R112.2, R114.2, U11.17 (P14)
unnamed: C37.1, R108.2, R110.2, U11.18 (P15)
unnamed: C35.1, R104.2, R106.2, U11.19 (P16)
unnamed: C33.1, R100.2, R102.2, U11.20 (P17)
unnamed: TP22.1, U11.1 (~INT)
unnamed: C48.1, R165.2, R169.2, U12.4 (P00)
unnamed: C52.1, R173.2, R177.2, U12.5 (P01)
unnamed: C56.1, R181.2, R185.2, U12.6 (P02)
unnamed: C60.1, R189.2, R193.2, U12.7 (P03)
unnamed: C64.1, R197.2, R201.2, U12.8 (P04)
unnamed: C68.1, R205.2, R209.2, U12.9 (P05)
unnamed: C72.1, R213.2, R217.2, U12.10 (P06)
unnamed: C76.1, R221.2, R225.2, U12.11 (P07)
unnamed: C77.1, R222.2, R226.2, U12.13 (P10)
unnamed: C73.1, R214.2, R218.2, U12.14 (P11)
unnamed: C69.1, R206.2, R210.2, U12.15 (P12)
unnamed: C65.1, R198.2, R202.2, U12.16 (P13)
unnamed: C61.1, R190.2, R194.2, U12.17 (P14)
unnamed: C57.1, R182.2, R186.2, U12.18 (P15)
unnamed: C53.1, R174.2, R178.2, U12.19 (P16)
unnamed: C49.1, R166.2, R170.2, U12.20 (P17)
unnamed: TP23.1, U12.1 (~INT)
unnamed: C50.1, R167.2, R171.2, U13.4 (P00)
unnamed: C54.1, R175.2, R179.2, U13.5 (P01)
unnamed: C58.1, R183.2, R187.2, U13.6 (P02)
unnamed: C62.1, R191.2, R195.2, U13.7 (P03)
unnamed: C66.1, R199.2, R203.2, U13.8 (P04)
unnamed: C70.1, R207.2, R211.2, U13.9 (P05)
unnamed: C74.1, R215.2, R219.2, U13.10 (P06)
unnamed: C78.1, R223.2, R227.2, U13.11 (P07)
unnamed: C79.1, R224.2, R228.2, U13.13 (P10)
unnamed: C75.1, R216.2, R220.2, U13.14 (P11)
unnamed: C71.1, R208.2, R212.2, U13.15 (P12)
unnamed: C67.1, R200.2, R204.2, U13.16 (P13)
unnamed: C63.1, R192.2, R196.2, U13.17 (P14)
unnamed: C59.1, R184.2, R188.2, U13.18 (P15)
unnamed: C55.1, R176.2, R180.2, U13.19 (P16)
unnamed: C51.1, R168.2, R172.2, U13.20 (P17)
unnamed: TP24.1, U13.1 (~INT)
unnamed: C13.1, R67.2, R75.2, U23.4 (P00)
unnamed: C14.1, R68.2, R76.2, U23.5 (P01)
unnamed: C15.1, R69.2, R77.2, U23.6 (P02)
unnamed: C16.1, R70.2, R78.2, U23.7 (P03)
unnamed: C17.1, R71.2, R79.2, U23.8 (P04)
unnamed: C18.1, R72.2, R80.2, U23.9 (P05)
unnamed: C19.1, R73.2, R81.2, U23.10 (P06)
unnamed: C23.1, R74.2, R82.2, U23.11 (P07)
unnamed: C31.1, R97.2, R98.2, U23.13 (P10)
unnamed: C30.1, R95.2, R96.2, U23.14 (P11)
unnamed: C29.1, R93.2, R94.2, U23.15 (P12)
unnamed: C28.1, R91.2, R92.2, U23.16 (P13)
unnamed: C27.1, R89.2, R90.2, U23.17 (P14)
unnamed: C26.1, R87.2, R88.2, U23.18 (P15)
unnamed: C25.1, R85.2, R86.2, U23.19 (P16)
unnamed: C24.1, R83.2, R84.2, U23.20 (P17)
unnamed: TP21.1, U23.1 (~INT)
