Swimnato/Simulation-Main-Board/Main Board.kicad_pcb

## KiCad design Main Board.kicad_pcb (continued)

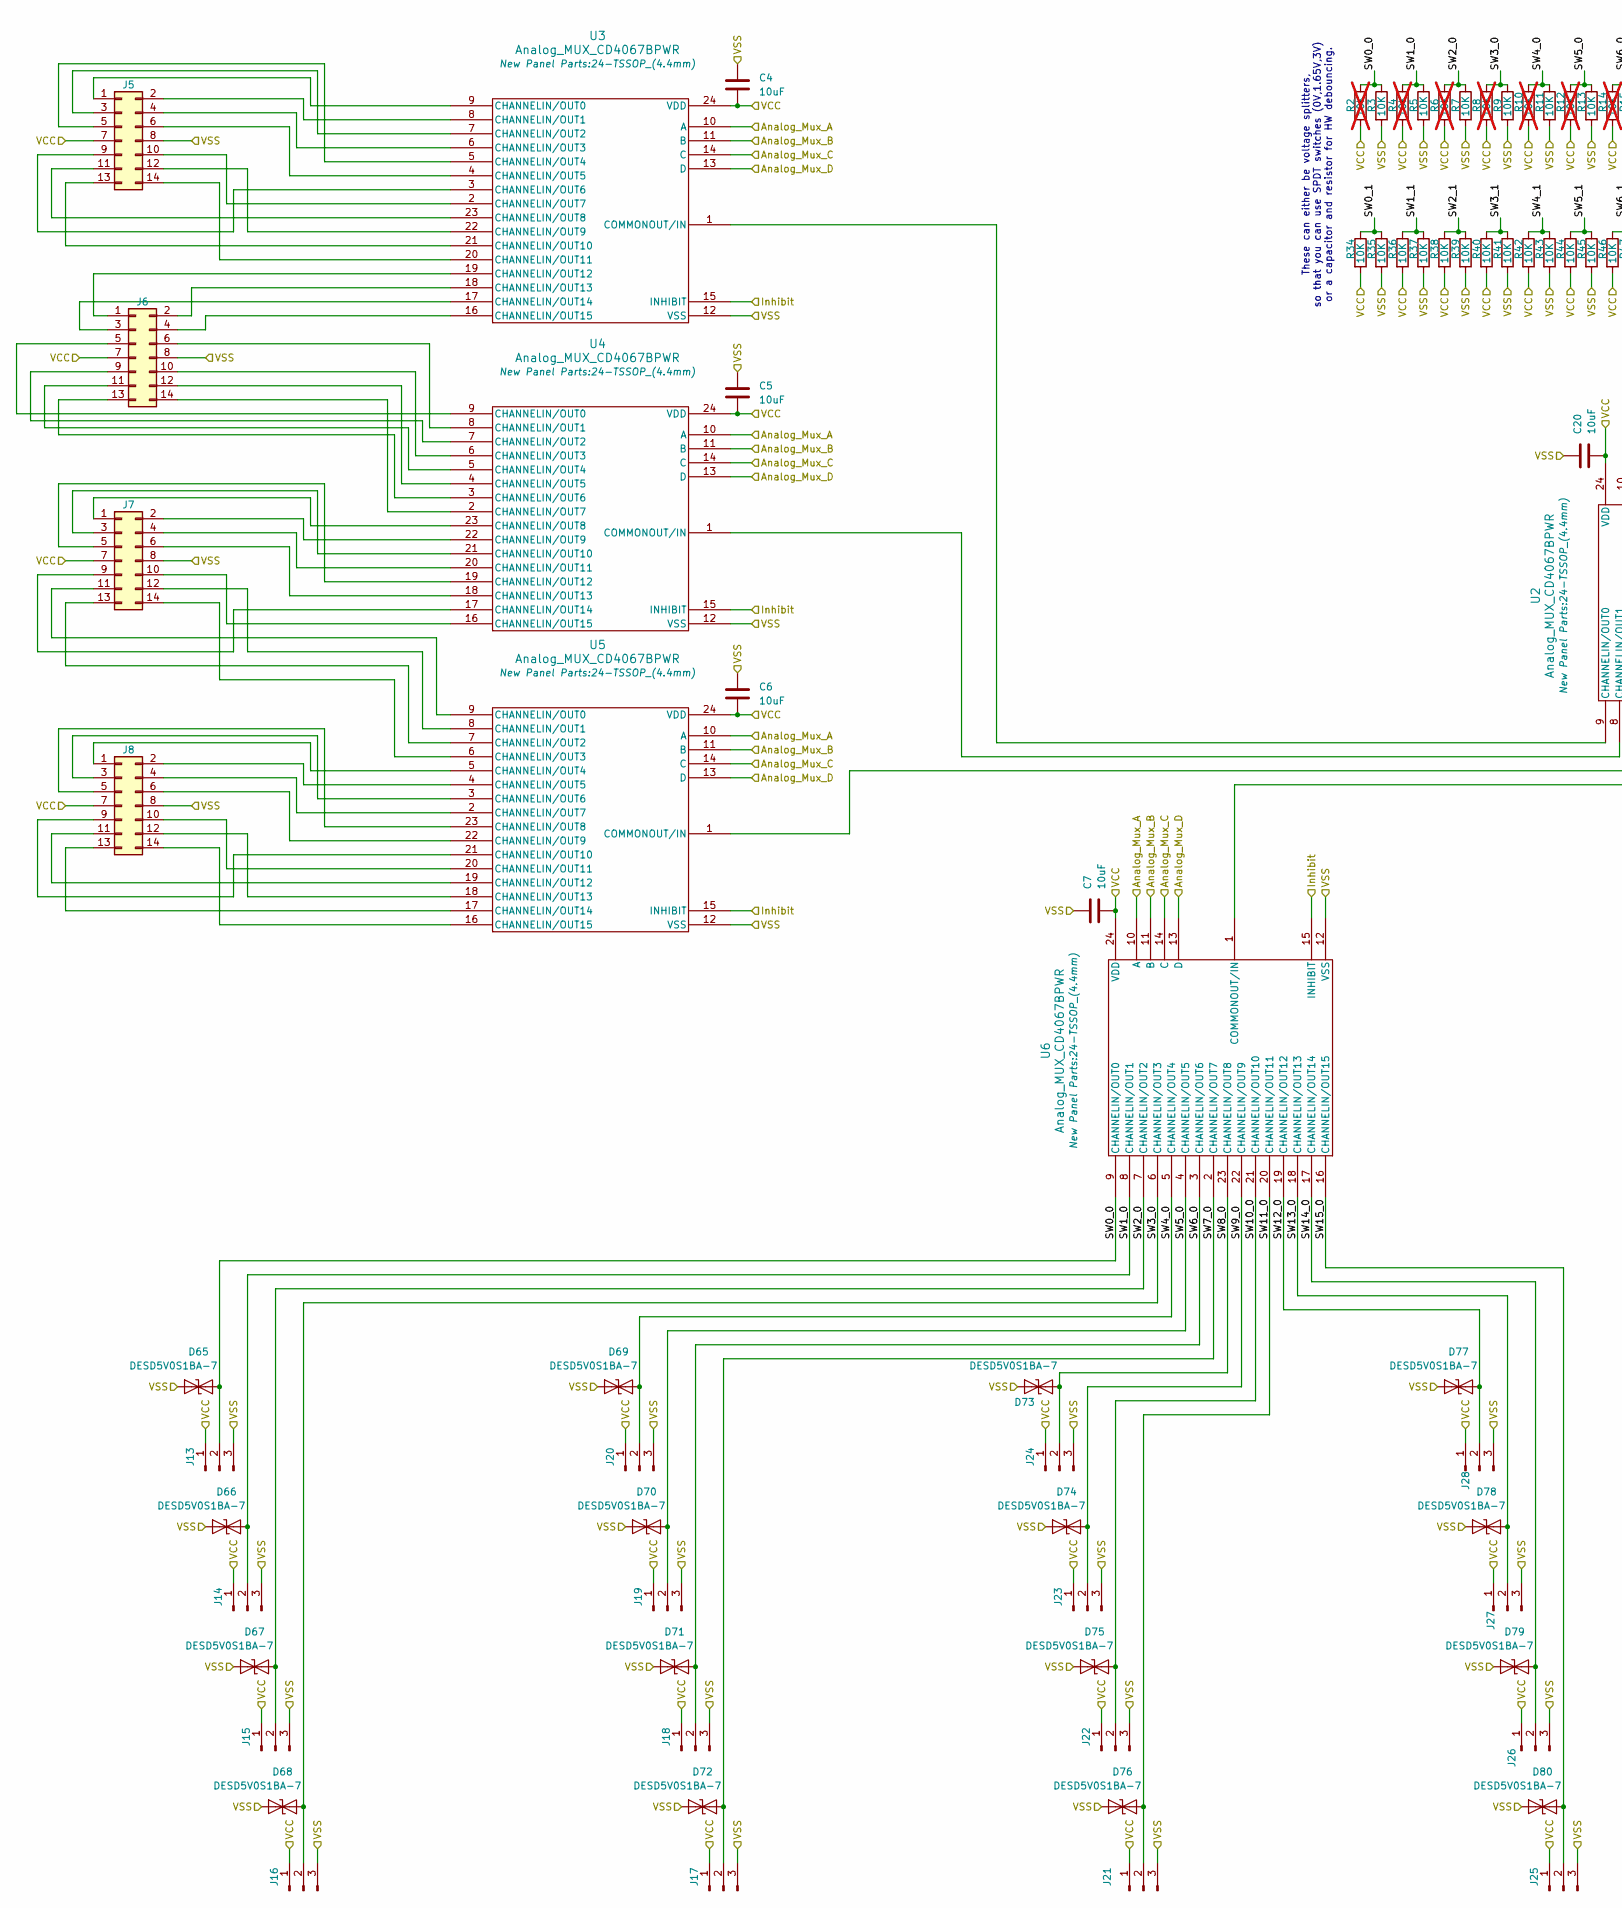
[picture p18: schematic Analog Muxes.kicad_sch, Main Universal Panel Board, part in row 1, column 1]

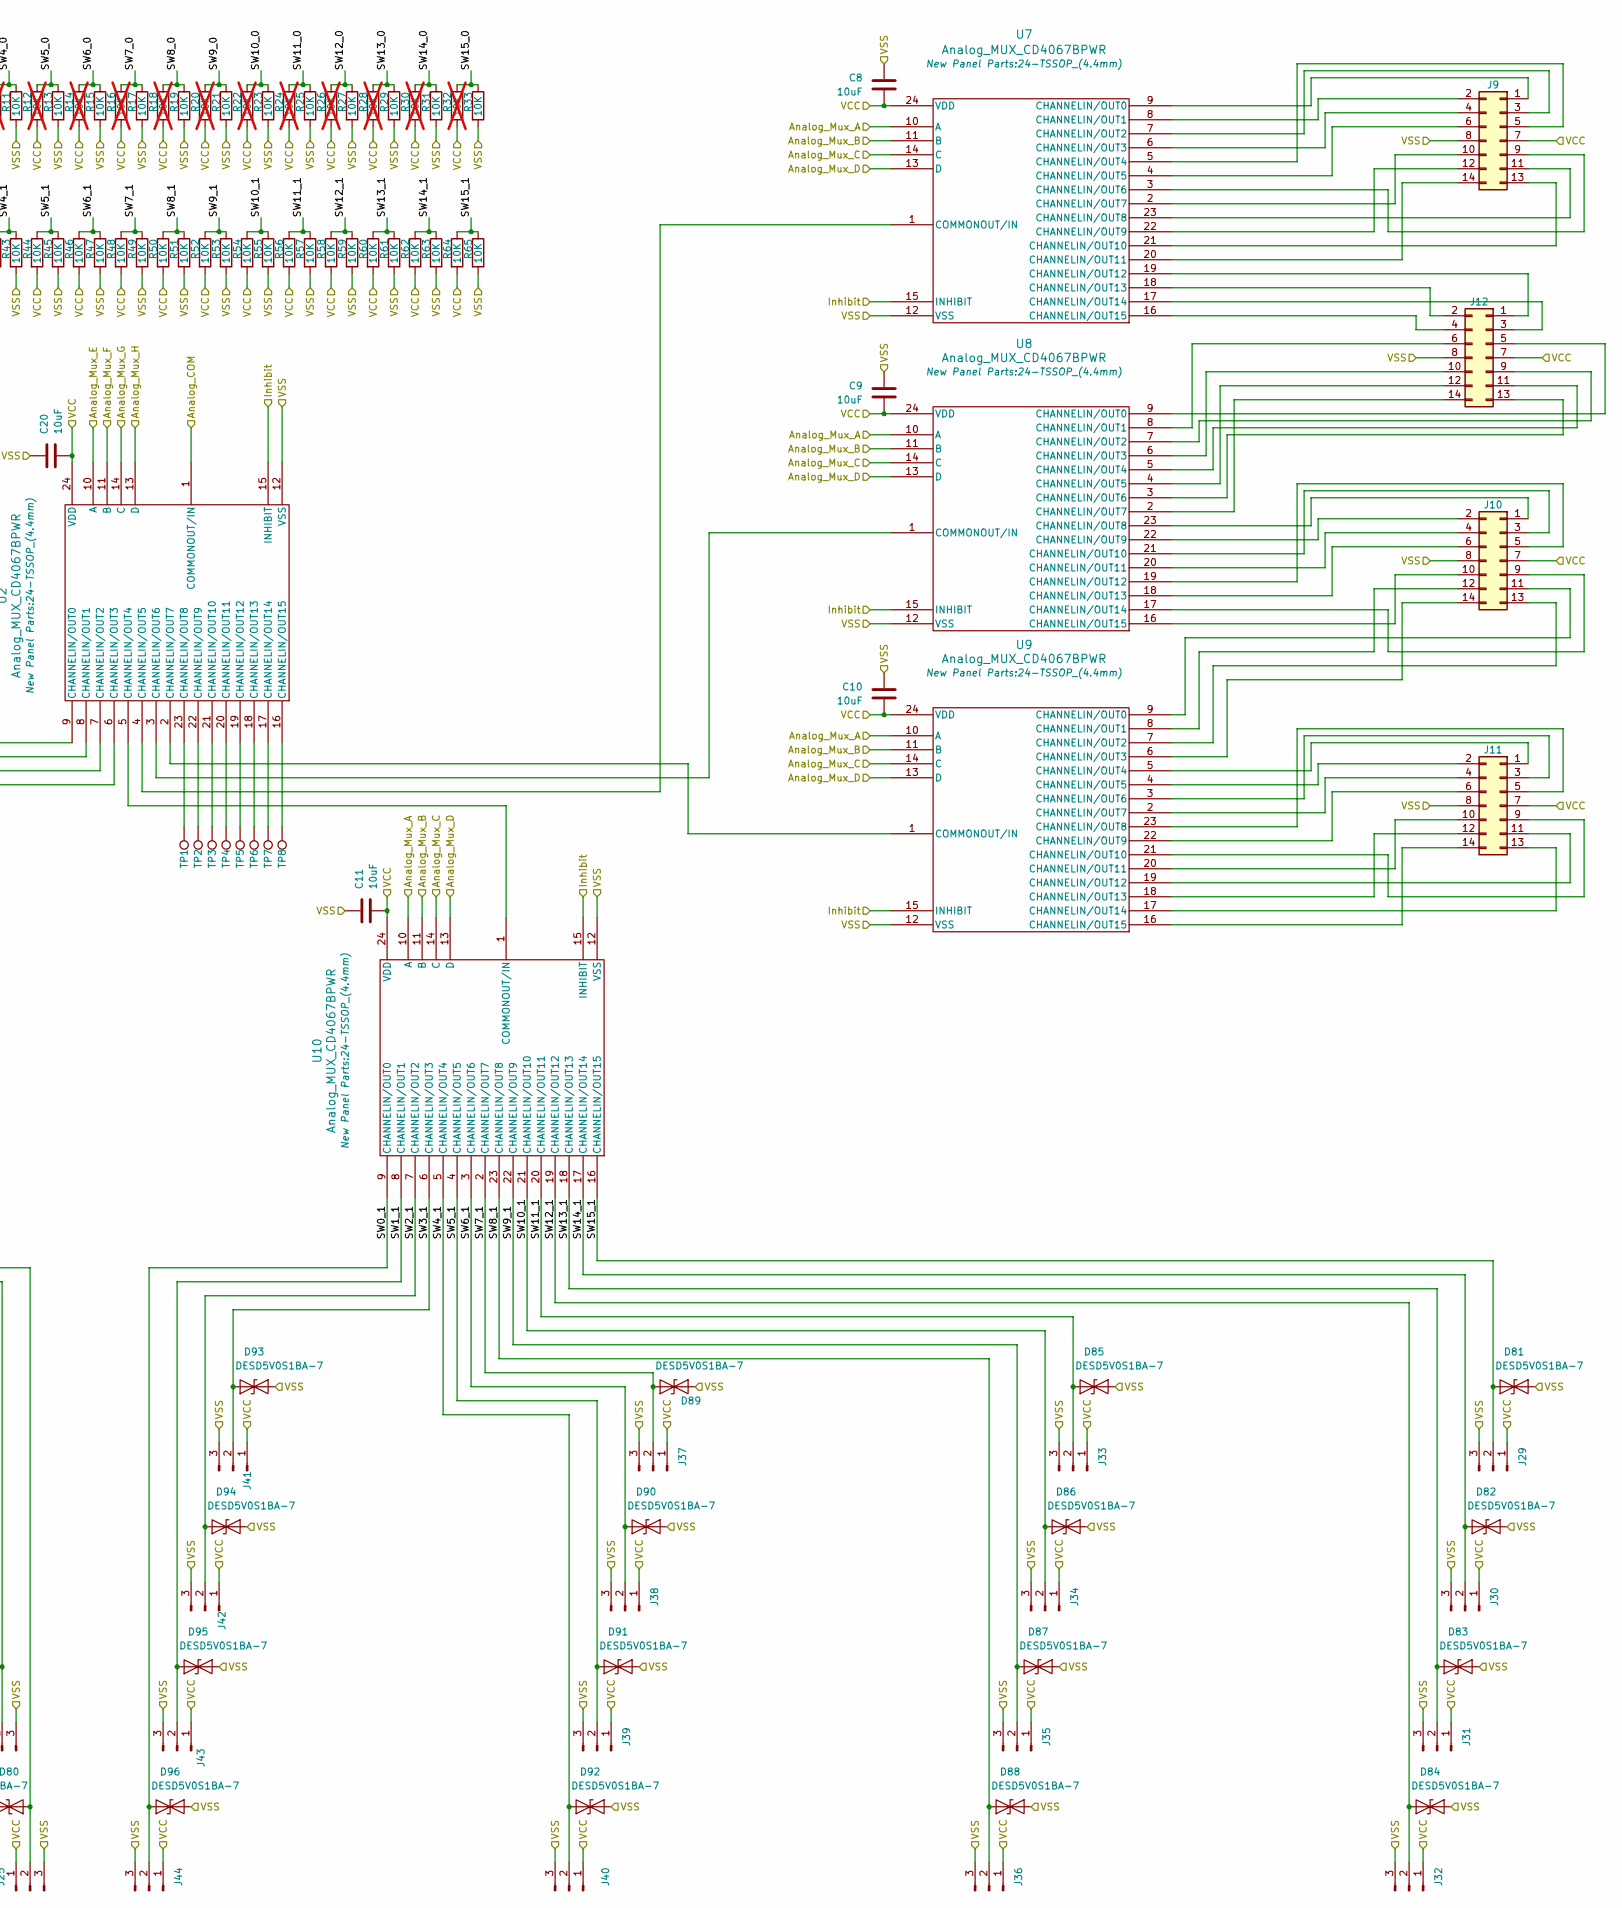
[picture p19: schematic Analog Muxes.kicad_sch, Main Universal Panel Board, part in row 1, column 2]

Parts:
C4, C5, C6, C7, C8, C9, C10, C11, C20: 10uF; C_0805_2012Metric_Pad1.18x1.45mm_HandSolder
D65, D66, D67, D68, D69, D70, D71, D72, D73, D74, D75, D76, D77, D78, D79, D80, D81, D82, D83, D84, D85, D86, D87, D88, D89, D90, D91, D92, D93, D94, D95, D96: DESD5V0S1BA-7; D_SOD-323
J5, J6, J7, J8, J9, J10, J11, J12: Conn_02x07_Odd_Even; IDC-Header_2x07_P2.54mm_Vertical
J13, J14, J15, J16, J17, J18, J19, J20, J21, J22, J23, J24, J25, J26, J27, J28, J29, J30, J31, J32, J33, J34, J35, J36, J37, J38, J39, J40, J41, J42, J43, J44: Conn_01x03_Pin; JST_PH_B3B-PH-K_1x03_P2.00mm_Vertical
R2, R4, R6, R8, R10, R12, R14, R16, R18, R20, R22, R24, R26, R28, R30, R32: 10K; R_0603_1608Metric; not fitted
R3, R5, R7, R9, R11, R13, R15, R17, R19, R21, R23, R25, R27, R29, R31, R33, R34, R35, R36, R37, R38, R39, R40, R41, R42, R43, R44, R45, R46, R47, R48, R49, R50, R51, R52, R53, R54, R55, R56, R57, R58, R59, R60, R61, R62, R63, R64, R65: 10K; R_0603_1608Metric
TP1, TP2, TP3, TP4, TP5, TP6, TP7, TP8: TestPoint; Pin_D1.0mm_L10.0mm
U2, U3, U4, U5, U6, U7, U8, U9, U10: Analog_MUX_CD4067BPWR; 24-TSSOP_(4.4mm); Manufacturer Part Number CD4067BPWR

Connections:
+3.3V: C4.2, C5.2, C6.2, C7.2, C8.2, C9.2, C10.2, C11.2, C20.2, J5.7, J6.7, J7.7, J8.7, J9.7, J10.7, J11.7, J12.7, J13.1, J14.1, J15.1, J16.1, J17.1, J18.1, J19.1, J20.1, J21.1, J22.1, J23.1, J24.1, J25.1, J26.1, J27.1, J28.1, J29.1, J30.1, J31.1, J32.1, J33.1, J34.1, J35.1, J36.1, J37.1, J38.1, J39.1, J40.1, J41.1, J42.1, J43.1, J44.1, R2.2, R4.2, R6.2, R8.2, R10.2, R12.2, R14.2, R16.2, R18.2, R20.2, R22.2, R24.2, R26.2, R28.2, R30.2, R32.2, R34.2, R36.2, R38.2, R40.2, R42.2, R44.2, R46.2, R48.2, R50.2, R52.2, R54.2, R56.2, R58.2, R60.2, R62.2, R64.2, U2.24 (VDD), U3.24 (VDD), U4.24 (VDD), U5.24 (VDD), U6.24 (VDD), U7.24 (VDD), U8.24 (VDD), U9.24 (VDD), U10.24 (VDD); also elsewhere on the board
/Analog Input Mux/Analog_COM: U2.1 (COMMONOUT/IN); also elsewhere on the board
/Analog Input Mux/Analog_Mux_A: U3.10 (A), U4.10 (A), U5.10 (A), U6.10 (A), U7.10 (A), U8.10 (A), U9.10 (A), U10.10 (A); also elsewhere on the board
/Analog Input Mux/Analog_Mux_B: U3.11 (B), U4.11 (B), U5.11 (B), U6.11 (B), U7.11 (B), U8.11 (B), U9.11 (B), U10.11 (B); also elsewhere on the board
/Analog Input Mux/Analog_Mux_C: U3.14 (C), U4.14 (C), U5.14 (C), U6.14 (C), U7.14 (C), U8.14 (C), U9.14 (C), U10.14 (C); also elsewhere on the board
/Analog Input Mux/Analog_Mux_D: U3.13 (D), U4.13 (D), U5.13 (D), U6.13 (D), U7.13 (D), U8.13 (D), U9.13 (D), U10.13 (D); also elsewhere on the board
/Analog Input Mux/Analog_Mux_E: U2.10 (A); also elsewhere on the board
/Analog Input Mux/Analog_Mux_F: U2.11 (B); also elsewhere on the board
/Analog Input Mux/Analog_Mux_G: U2.14 (C); also elsewhere on the board
/Analog Input Mux/Analog_Mux_H: U2.13 (D); also elsewhere on the board
/Analog Input Mux/Inhibit: U2.15 (INHIBIT), U3.15 (INHIBIT), U4.15 (INHIBIT), U5.15 (INHIBIT), U6.15 (INHIBIT), U7.15 (INHIBIT), U8.15 (INHIBIT), U9.15 (INHIBIT), U10.15 (INHIBIT); also elsewhere on the board
/Analog Input Mux/SW0_0: D65.1 (A1), J13.2, R2.1, R3.1, U6.9 (CHANNELIN/OUT0)
/Analog Input Mux/SW0_1: D96.1 (A1), J44.2, R34.1, R35.1, U10.9 (CHANNELIN/OUT0)
/Analog Input Mux/SW1_0: D66.1 (A1), J14.2, R4.1, R5.1, U6.8 (CHANNELIN/OUT1)
/Analog Input Mux/SW1_1: D95.1 (A1), J43.2, R36.1, R37.1, U10.8 (CHANNELIN/OUT1)
/Analog Input Mux/SW2_0: D67.1 (A1), J15.2, R6.1, R7.1, U6.7 (CHANNELIN/OUT2)
/Analog Input Mux/SW2_1: D94.1 (A1), J42.2, R38.1, R39.1, U10.7 (CHANNELIN/OUT2)
/Analog Input Mux/SW3_0: D68.1 (A1), J16.2, R8.1, R9.1, U6.6 (CHANNELIN/OUT3)
/Analog Input Mux/SW3_1: D93.1 (A1), J41.2, R40.1, R41.1, U10.6 (CHANNELIN/OUT3)
/Analog Input Mux/SW4_0: D69.1 (A1), J20.2, R10.1, R11.1, U6.5 (CHANNELIN/OUT4)
/Analog Input Mux/SW4_1: D92.1 (A1), J40.2, R42.1, R43.1, U10.5 (CHANNELIN/OUT4)
/Analog Input Mux/SW5_0: D70.1 (A1), J19.2, R12.1, R13.1, U6.4 (CHANNELIN/OUT5)
/Analog Input Mux/SW5_1: D91.1 (A1), J39.2, R44.1, R45.1, U10.4 (CHANNELIN/OUT5)
/Analog Input Mux/SW6_0: D71.1 (A1), J18.2, R14.1, R15.1, U6.3 (CHANNELIN/OUT6)
/Analog Input Mux/SW6_1: D90.1 (A1), J38.2, R46.1, R47.1, U10.3 (CHANNELIN/OUT6)
/Analog Input Mux/SW7_0: D72.1 (A1), J17.2, R16.1, R17.1, U6.2 (CHANNELIN/OUT7)
/Analog Input Mux/SW7_1: D89.1 (A1), J37.2, R48.1, R49.1, U10.2 (CHANNELIN/OUT7)
/Analog Input Mux/SW8_0: D73.1 (A1), J24.2, R18.1, R19.1, U6.23 (CHANNELIN/OUT8)
/Analog Input Mux/SW8_1: D88.1 (A1), J36.2, R50.1, R51.1, U10.23 (CHANNELIN/OUT8)
/Analog Input Mux/SW9_0: D74.1 (A1), J23.2, R20.1, R21.1, U6.22 (CHANNELIN/OUT9)
/Analog Input Mux/SW9_1: D87.1 (A1), J35.2, R52.1, R53.1, U10.22 (CHANNELIN/OUT9)
/Analog Input Mux/SW10_0: D75.1 (A1), J22.2, R22.1, R23.1, U6.21 (CHANNELIN/OUT10)
/Analog Input Mux/SW10_1: D86.1 (A1), J34.2, R54.1, R55.1, U10.21 (CHANNELIN/OUT10)
/Analog Input Mux/SW11_0: D76.1 (A1), J21.2, R24.1, R25.1, U6.20 (CHANNELIN/OUT11)
/Analog Input Mux/SW11_1: D85.1 (A1), J33.2, R56.1, R57.1, U10.20 (CHANNELIN/OUT11)
/Analog Input Mux/SW12_0: D77.1 (A1), J28.2, R26.1, R27.1, U6.19 (CHANNELIN/OUT12)
/Analog Input Mux/SW12_1: D84.1 (A1), J32.2, R58.1, R59.1, U10.19 (CHANNELIN/OUT12)
/Analog Input Mux/SW13_0: D78.1 (A1), J27.2, R28.1, R29.1, U6.18 (CHANNELIN/OUT13)
/Analog Input Mux/SW13_1: D83.1 (A1), J31.2, R60.1, R61.1, U10.18 (CHANNELIN/OUT13)
/Analog Input Mux/SW14_0: D79.1 (A1), J26.2, R30.1, R31.1, U6.17 (CHANNELIN/OUT14)
/Analog Input Mux/SW14_1: D82.1 (A1), J30.2, R62.1, R63.1, U10.17 (CHANNELIN/OUT14)
/Analog Input Mux/SW15_0: D80.1 (A1), J25.2, R32.1, R33.1, U6.16 (CHANNELIN/OUT15)
/Analog Input Mux/SW15_1: D81.1 (A1), J29.2, R64.1, R65.1, U10.16 (CHANNELIN/OUT15)
GND: C4.1, C5.1, C6.1, C7.1, C8.1, C9.1, C10.1, C11.1, C20.1, D65.2 (A2), D66.2 (A2), D67.2 (A2), D68.2 (A2), D69.2 (A2), D70.2 (A2), D71.2 (A2), D72.2 (A2), D73.2 (A2), D74.2 (A2), D75.2 (A2), D76.2 (A2), D77.2 (A2), D78.2 (A2), D79.2 (A2), D80.2 (A2), D81.2 (A2), D82.2 (A2), D83.2 (A2), D84.2 (A2), D85.2 (A2), D86.2 (A2), D87.2 (A2), D88.2 (A2), D89.2 (A2), D90.2 (A2), D91.2 (A2), D92.2 (A2), D93.2 (A2), D94.2 (A2), D95.2 (A2), D96.2 (A2), J5.8, J6.8, J7.8, J8.8, J9.8, J10.8, J11.8, J12.8, J13.3, J14.3, J15.3, J16.3, J17.3, J18.3, J19.3, J20.3, J21.3, J22.3, J23.3, J24.3, J25.3, J26.3, J27.3, J28.3, J29.3, J30.3, J31.3, J32.3, J33.3, J34.3, J35.3, J36.3, J37.3, J38.3, J39.3, J40.3, J41.3, J42.3, J43.3, J44.3, R3.2, R5.2, R7.2, R9.2, R11.2, R13.2, R15.2, R17.2, R19.2, R21.2, R23.2, R25.2, R27.2, R29.2, R31.2, R33.2, R35.2, R37.2, R39.2, R41.2, R43.2, R45.2, R47.2, R49.2, R51.2, R53.2, R55.2, R57.2, R59.2, R61.2, R63.2, R65.2, U2.12 (VSS), U3.12 (VSS), U4.12 (VSS), U5.12 (VSS), U6.12 (VSS), U7.12 (VSS), U8.12 (VSS), U9.12 (VSS), U10.12 (VSS); also elsewhere on the board
unnamed: J5.1, U3.9 (CHANNELIN/OUT0)
unnamed: J5.2, U3.8 (CHANNELIN/OUT1)
unnamed: J5.3, U3.7 (CHANNELIN/OUT2)
unnamed: J5.4, U3.6 (CHANNELIN/OUT3)
unnamed: J5.5, U3.5 (CHANNELIN/OUT4)
unnamed: J5.6, U3.4 (CHANNELIN/OUT5)
unnamed: J5.9, U3.3 (CHANNELIN/OUT6)
unnamed: J5.10, U3.2 (CHANNELIN/OUT7)
unnamed: J5.11, U3.23 (CHANNELIN/OUT8)
unnamed: J5.12, U3.22 (CHANNELIN/OUT9)
unnamed: J5.13, U3.21 (CHANNELIN/OUT10)
unnamed: J5.14, U3.20 (CHANNELIN/OUT11)
unnamed: J6.1, U3.19 (CHANNELIN/OUT12)
unnamed: J6.2, U3.18 (CHANNELIN/OUT13)
unnamed: J6.3, U3.17 (CHANNELIN/OUT14)
unnamed: J6.4, U3.16 (CHANNELIN/OUT15)
unnamed: J6.5, U4.9 (CHANNELIN/OUT0)
unnamed: J6.6, U4.8 (CHANNELIN/OUT1)
unnamed: J6.9, U4.7 (CHANNELIN/OUT2)
unnamed: J6.10, U4.6 (CHANNELIN/OUT3)
unnamed: J6.11, U4.5 (CHANNELIN/OUT4)
unnamed: J6.12, U4.4 (CHANNELIN/OUT5)
unnamed: J6.13, U4.3 (CHANNELIN/OUT6)
unnamed: J6.14, U4.2 (CHANNELIN/OUT7)
unnamed: J7.1, U4.23 (CHANNELIN/OUT8)
unnamed: J7.2, U4.22 (CHANNELIN/OUT9)
unnamed: J7.3, U4.21 (CHANNELIN/OUT10)
unnamed: J7.4, U4.20 (CHANNELIN/OUT11)
unnamed: J7.5, U4.19 (CHANNELIN/OUT12)
unnamed: J7.6, U4.18 (CHANNELIN/OUT13)
unnamed: J7.9, U4.17 (CHANNELIN/OUT14)
unnamed: J7.10, U4.16 (CHANNELIN/OUT15)
unnamed: J7.11, U5.9 (CHANNELIN/OUT0)
unnamed: J7.12, U5.8 (CHANNELIN/OUT1)
unnamed: J7.13, U5.7 (CHANNELIN/OUT2)
unnamed: J7.14, U5.6 (CHANNELIN/OUT3)
unnamed: J8.1, U5.5 (CHANNELIN/OUT4)
unnamed: J8.2, U5.4 (CHANNELIN/OUT5)
unnamed: J8.3, U5.3 (CHANNELIN/OUT6)
unnamed: J8.4, U5.2 (CHANNELIN/OUT7)
unnamed: J8.5, U5.23 (CHANNELIN/OUT8)
unnamed: J8.6, U5.22 (CHANNELIN/OUT9)
unnamed: J8.9, U5.21 (CHANNELIN/OUT10)
unnamed: J8.10, U5.20 (CHANNELIN/OUT11)
unnamed: J8.11, U5.19 (CHANNELIN/OUT12)
unnamed: J8.12, U5.18 (CHANNELIN/OUT13)
unnamed: J8.13, U5.17 (CHANNELIN/OUT14)
unnamed: J8.14, U5.16 (CHANNELIN/OUT15)
unnamed: J9.1, U7.9 (CHANNELIN/OUT0)
unnamed: J9.2, U7.8 (CHANNELIN/OUT1)
unnamed: J9.3, U7.7 (CHANNELIN/OUT2)
unnamed: J9.4, U7.6 (CHANNELIN/OUT3)
unnamed: J9.5, U7.5 (CHANNELIN/OUT4)
unnamed: J9.6, U7.4 (CHANNELIN/OUT5)
unnamed: J9.9, U7.3 (CHANNELIN/OUT6)
unnamed: J9.10, U7.2 (CHANNELIN/OUT7)
unnamed: J9.11, U7.23 (CHANNELIN/OUT8)
unnamed: J9.12, U7.22 (CHANNELIN/OUT9)
unnamed: J9.13, U7.21 (CHANNELIN/OUT10)
unnamed: J9.14, U7.20 (CHANNELIN/OUT11)
unnamed: J10.1, U8.23 (CHANNELIN/OUT8)
unnamed: J10.2, U8.22 (CHANNELIN/OUT9)
unnamed: J10.3, U8.21 (CHANNELIN/OUT10)
unnamed: J10.4, U8.20 (CHANNELIN/OUT11)
unnamed: J10.5, U8.19 (CHANNELIN/OUT12)
unnamed: J10.6, U8.18 (CHANNELIN/OUT13)
unnamed: J10.9, U8.17 (CHANNELIN/OUT14)
unnamed: J10.10, U8.16 (CHANNELIN/OUT15)
unnamed: J10.11, U9.9 (CHANNELIN/OUT0)
unnamed: J10.12, U9.8 (CHANNELIN/OUT1)
unnamed: J10.13, U9.7 (CHANNELIN/OUT2)
unnamed: J10.14, U9.6 (CHANNELIN/OUT3)
unnamed: J11.1, U9.5 (CHANNELIN/OUT4)
unnamed: J11.2, U9.4 (CHANNELIN/OUT5)
unnamed: J11.3, U9.3 (CHANNELIN/OUT6)
unnamed: J11.4, U9.2 (CHANNELIN/OUT7)
unnamed: J11.5, U9.23 (CHANNELIN/OUT8)
unnamed: J11.6, U9.22 (CHANNELIN/OUT9)
unnamed: J11.9, U9.21 (CHANNELIN/OUT10)
unnamed: J11.10, U9.20 (CHANNELIN/OUT11)
unnamed: J11.11, U9.19 (CHANNELIN/OUT12)
unnamed: J11.12, U9.18 (CHANNELIN/OUT13)
unnamed: J11.13, U9.17 (CHANNELIN/OUT14)
unnamed: J11.14, U9.16 (CHANNELIN/OUT15)
unnamed: J12.1, U7.19 (CHANNELIN/OUT12)
unnamed: J12.2, U7.18 (CHANNELIN/OUT13)
unnamed: J12.3, U7.17 (CHANNELIN/OUT14)
unnamed: J12.4, U7.16 (CHANNELIN/OUT15)
unnamed: J12.5, U8.9 (CHANNELIN/OUT0)
unnamed: J12.6, U8.8 (CHANNELIN/OUT1)
unnamed: J12.9, U8.7 (CHANNELIN/OUT2)
unnamed: J12.10, U8.6 (CHANNELIN/OUT3)
unnamed: J12.11, U8.5 (CHANNELIN/OUT4)
unnamed: J12.12, U8.4 (CHANNELIN/OUT5)
unnamed: J12.13, U8.3 (CHANNELIN/OUT6)
unnamed: J12.14, U8.2 (CHANNELIN/OUT7)
unnamed: U2.9 (CHANNELIN/OUT0), U3.1 (COMMONOUT/IN)
unnamed: U2.8 (CHANNELIN/OUT1), U4.1 (COMMONOUT/IN)
unnamed: U2.7 (CHANNELIN/OUT2), U5.1 (COMMONOUT/IN)
unnamed: U2.6 (CHANNELIN/OUT3), U6.1 (COMMONOUT/IN)
unnamed: U2.4 (CHANNELIN/OUT5), U7.1 (COMMONOUT/IN)
unnamed: U2.3 (CHANNELIN/OUT6), U8.1 (COMMONOUT/IN)
unnamed: U2.2 (CHANNELIN/OUT7), U9.1 (COMMONOUT/IN)
unnamed: TP1.1, U2.23 (CHANNELIN/OUT8)
unnamed: TP2.1, U2.22 (CHANNELIN/OUT9)
unnamed: TP3.1, U2.21 (CHANNELIN/OUT10)
unnamed: TP4.1, U2.20 (CHANNELIN/OUT11)
unnamed: TP5.1, U2.19 (CHANNELIN/OUT12)
unnamed: TP6.1, U2.18 (CHANNELIN/OUT13)
unnamed: TP7.1, U2.17 (CHANNELIN/OUT14)
unnamed: TP8.1, U2.16 (CHANNELIN/OUT15)
unnamed: U2.5 (CHANNELIN/OUT4), U10.1 (COMMONOUT/IN)

Notes on the sheet:
These can either be voltage splitters, so that you can use SPDT switches (0V,1.65V,3V) or a capacitor and resistor for HW debouncing.

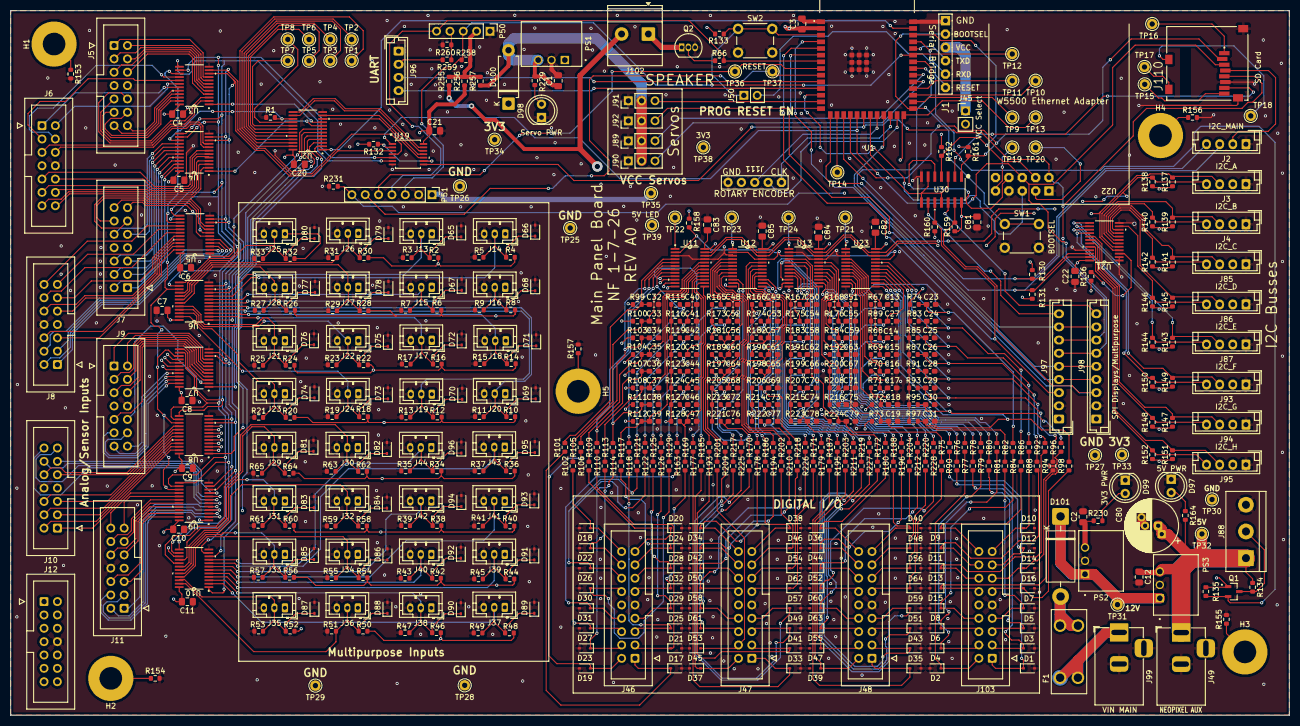
[picture p20: board Main Board.kicad_pcb from above]

Board: 4 copper layers, 243.2 x 134.0 mm, 564 parts (0 on the bottom side), 363 nets.
