Swimnato/Simulation-Main-Board/(commit log)

2025-09-20 Move Over from subsytem repo
    This was moved over from the subsystem repository in the osirus project. It is better suited here alone in its own repo
    [Analog Muxes.kicad_sch, BOM JLCPCB Assembly.xlsx, BOM Part Numbers.xlsx, ESP32-S3-WROOM-1-N16.STEP, IO Expanders.kicad_sch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]
2025-09-20 Refining BOM & X4
    X4 included a diode to protect from reverse polarity DC input. Begun work on Digikey BOM
    [Analog Muxes.kicad_sch, BOM JLCPCB Assembly.xlsx, Digikey Parts.xlsx, IO Expanders.kicad_sch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]
2025-09-20 Refined BOM
    Adjusted BOM to have all parts
    [Ali_Express Parts.xlsx, Digikey Parts.xlsx]
2025-10-10 Started HW Testing
    Started HW testing and on main sim board library.
    [Main Board-top-pos.csv]
2025-10-10 Fixed some typos in the pin definition
2025-10-11 started work on testing code
    [Main Board-top-pos.csv]
2025-10-14 Finished Digital IO driver
2025-10-14 Wrote I2C Mux Code
2025-10-14 Added Second UART Code
2026-01-07 Rev A0
    REV A0 changes, additionally added STEP files for PAM8302, MAX98357, and JST XH 4 connector for UART. Updated KiCad schematic and PCB files, reorganized BOM and pick-and-place files for new revisions, and refreshed CAM data.
    [2130 PAM8302.step, 3006 MAX98357.step, Ali_Express Parts.xlsx, Analog Muxes.kicad_sch, BOM JLCPCB Assembly A0.xlsx, BOM JLCPCB Assembly.xlsx, Digikey Parts.xlsx, IO Expanders.kicad_sch]
2026-01-08 Finished Release Package
    [Ali_Express Parts.xlsx, BOM JLCPCB Assembly A0.xlsx, BOM JLCPCB Assembly.xlsx, BOM Part Numbers.xlsx, Digikey Parts.xlsx, Main Board 3D Model A0.3mf, Main Board-pick-and-place_A0.csv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]
2026-01-09 Added 2 test points
    for possible logic level converters
    [Digikey Parts.xlsx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]
